RoaldVG/transistor-clock/modules/jkflipflop/production/bom.csv

Designator | Footprint | Quantity | Value | LCSC Part #
C1, C2, C3, C4, C5, C6, C7, C8 | 0603 | 8 | 100n | C14663
Q1, Q101, Q102, Q103, Q104, Q110, Q111, Q112, Q113, Q116, Q117, Q120, Q121, Q124, Q125, Q128, Q129, Q13, Q132, Q133, Q136, Q137, Q14, Q140, Q141, Q144, Q145, Q148, Q149, Q15, Q152, Q153, Q156, Q157, Q160, Q161, Q164, Q165, Q168, Q19, Q20, Q21, Q23, Q27, Q28, Q29, Q3, Q33, Q34, Q35, Q39, Q40, Q41, Q45, Q46, Q47, Q51, Q52, Q53, Q56, Q57, Q59, Q63, Q64, Q65, Q69, Q7, Q70, Q71, Q75, Q76, Q77, Q79, Q8, Q83, Q84, Q85, Q89, Q9, Q90, Q91, Q95, Q96, Q97 | SOT-23 | 84 | AO3401A | C15127
Q10, Q100, Q105, Q106, Q107, Q108, Q109, Q11, Q114, Q115, Q118, Q119, Q12, Q122, Q123, Q126, Q127, Q130, Q131, Q134, Q135, Q138, Q139, Q142, Q143, Q146, Q147, Q150, Q151, Q154, Q155, Q158, Q159, Q16, Q162, Q163, Q166, Q167, Q17, Q18, Q2, Q22, Q24, Q25, Q26, Q30, Q31, Q32, Q36, Q37, Q38, Q4, Q42, Q43, Q44, Q48, Q49, Q5, Q50, Q54, Q55, Q58, Q6, Q60, Q61, Q62, Q66, Q67, Q68, Q72, Q73, Q74, Q78, Q80, Q81, Q82, Q86, Q87, Q88, Q92, Q93, Q94, Q98, Q99 | SOT-23 | 84 | 2N7002 | C8545
