RoaldVG/transistor-clock/modules/bin-to-dec/production/bom.csv

Designator | Footprint | Quantity | Value | LCSC Part #
C1, C2, C3 | 0603 | 3 | 100n | C14663
Q1, Q10, Q11, Q14, Q16, Q18, Q19, Q20, Q21, Q25, Q28, Q29, Q30, Q31, Q32, Q38, Q39, Q4, Q40, Q42, Q43, Q45, Q46, Q48, Q49, Q51, Q57, Q58, Q6, Q60, Q63, Q68, Q69, Q7, Q71, Q73, Q9 | SOT-23 | 37 | 2N7002 | C8545
Q12, Q13, Q15, Q17, Q2, Q22, Q23, Q24, Q26, Q27, Q3, Q33, Q34, Q35, Q36, Q37, Q41, Q44, Q47, Q5, Q50, Q52, Q53, Q54, Q55, Q56, Q59, Q61, Q62, Q64, Q65, Q66, Q67, Q70, Q72, Q74, Q8 | SOT-23 | 37 | AO3401A | C15127
