RoaldVG/transistor-clock/sims/astable-multivibrator-sqr-12v.asc

C1: Cap; 10n
C2: Cap; 10n
C3: cap; 10n
L1: ind; 750µ; Rser=1m
L2: ind; 3.6nH; Rser=1m
M1: nmos; 2N7002
M2: pmos; DMP3099L
Q1: npn; 2N2222
Q2: npn; 2N2222
R1: Res; 15k
R2: Res; 130k
R3: Res; 130k
R4: Res; 15k
R5: res; 1k
R6: res; 1k
R7: res; 10
V1: Voltage; 12
V2: voltage; -12
Named nets: 0, V-out-2, V-out-1, out
.tran 10ms uic
*---------- DMP3099L Spice Model ----------
.SUBCKT DMP3099L 10 20 30
* TERMINALS : D G S
* MODEL FORMAT : SPICE3
* Editor : J
M1 1 2 3 3 PMOS L = 1E-006 W = 1E-006
RD 10 1 0.034
RS 30 3 0.001
RG 20 2 10.27
CGS 2 3 5.402E-010
EGD 12 30 2 1 1
VFB 14 30 0
FFB 2 1 VFB 1
CGD 13 14 4.4E-010
R1 13 30 1
D1 13 12 DLIM
DDG 14 15 DCGD
R2 12 15 1
D2 30 15 DLIM
DSD 10 3 DSUB
.MODEL PMOS PMOS LEVEL = 3 U0 = 400 VMAX = 1E+005 ETA = 0 IS = 0
+ TOX = 1E-007 NSUB = 1E+015 KP = 11.4 KAPPA = 0.2 VTO = -1.951
.MODEL DCGD D CJO = 2.23E-010 VJ = 0.5007 M = 0.4371
.MODEL DSUB D IS = 2.1E-009 N = 1.535 RS = 0.01225 BV = 33
+ CJO = 5.41E-011 VJ = 0.6 M = 0.5308 XTI=0
.MODEL DLIM D IS = 0.0001
.ENDS
K1 L1 L2 1
