RoaldVG/transistor-clock/modules/PSU/PSU.kicad_pcb

## KiCad design modules/PSU/PSU.kicad_pcb (2026-04-15)

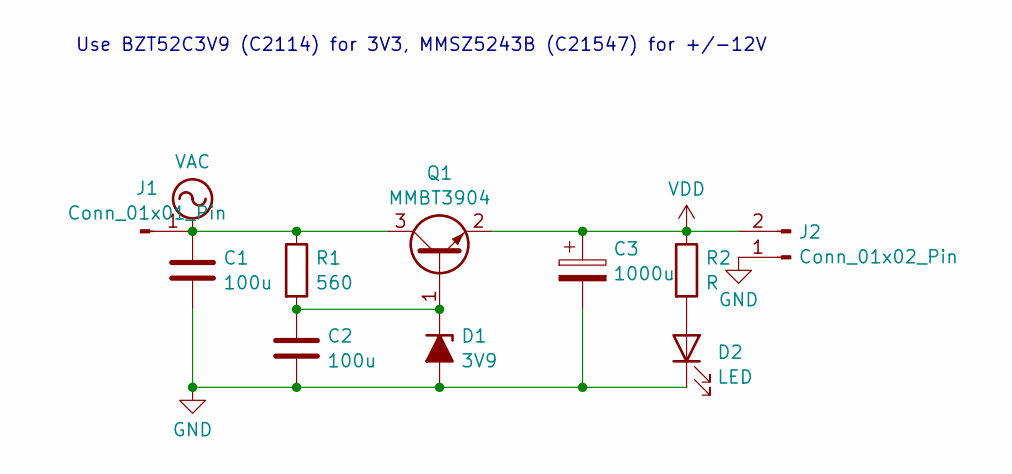
[picture p1: schematic PSU.kicad_sch]

Parts:
C1, C2: 100u; CP_EIA-3528-12_Kemet-T; LCSC Part # C16133
C3: 1000u; CP_Elec_10x10.5; LCSC Part # C3359
D1: 3V9; D_SOD-123; LCSC Part # C2114
D2: LED; LED_0603_1608Metric
J1: Conn_01x01_Pin; PinHeader_1x01_P2.54mm_Vertical
J2: Conn_01x02_Pin; PinHeader_1x02_P2.54mm_Vertical
Q1: MMBT3904; SOT-23; LCSC Part # C20526v
R1: 560; R_0603_1608Metric; LCSC Part # C23204
R2: R; R_0603_1608Metric

Connections:
GND: C1.2, C2.1, C3.2, D1.2 (A), D2.1 (K), J2.1
unnamed: C2.2, D1.1 (K), Q1.1 (B), R1.2
unnamed: D2.2 (A), R2.2
VAC: C1.1, J1.1, Q1.3 (C), R1.1
VDD: C3.1, J2.2, Q1.2 (E), R2.1

Notes on the sheet:
Use BZT52C3V9 (C2114) for 3V3, MMSZ5243B (C21547) for +/-12V

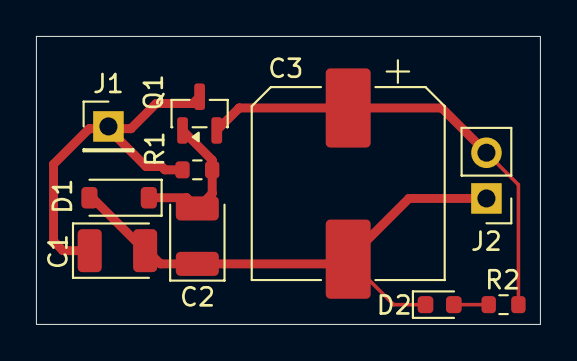
[picture p2: board PSU.kicad_pcb from above]

Board: 2 copper layers, 28.0 x 16.0 mm, 10 parts (0 on the bottom side), 5 nets.
