RoaldVG/transistor-clock/transistor-clock.kicad_pcb

## KiCad design transistor-clock.kicad_pcb (2026-04-15)

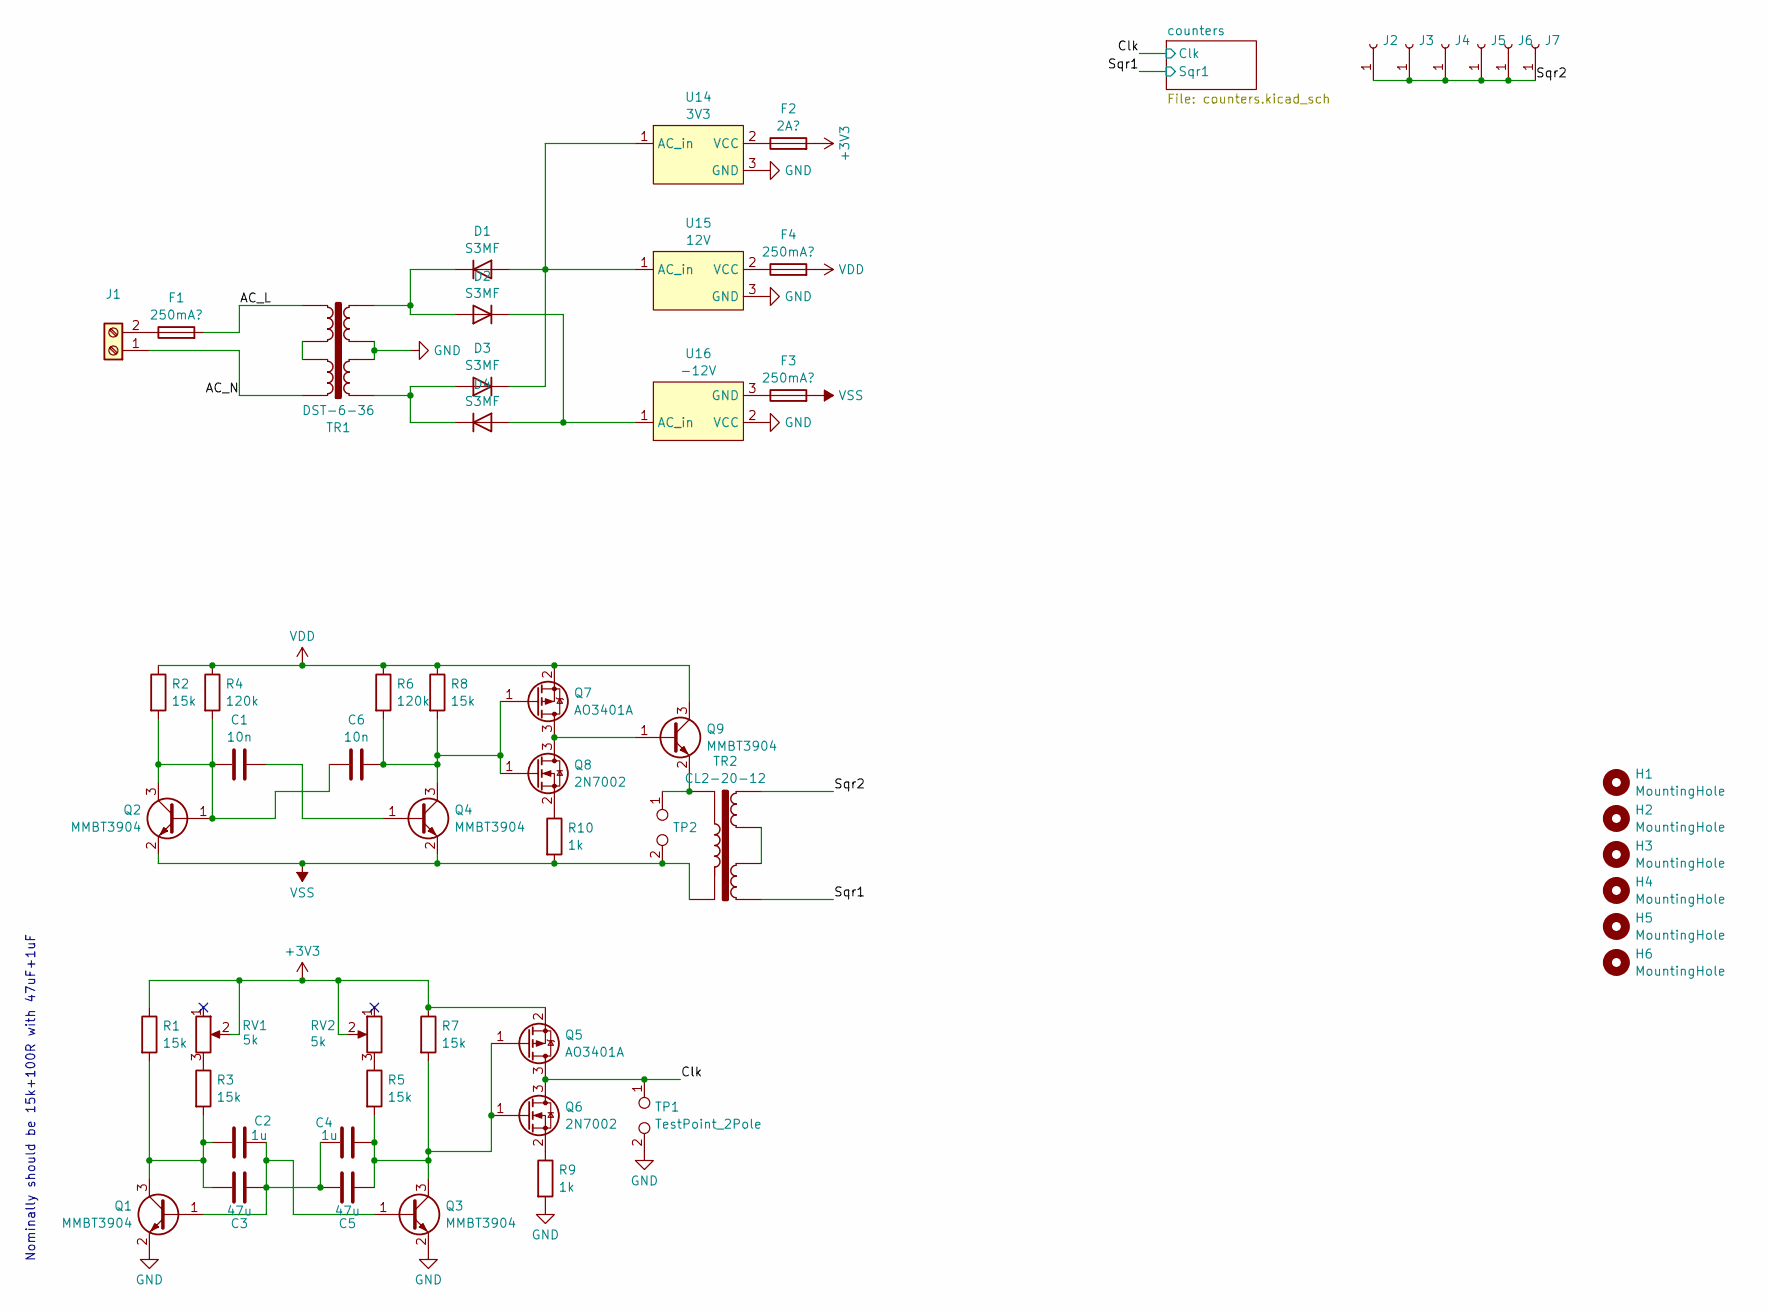
[picture p3: schematic transistor-clock.kicad_sch]

Parts:
C1, C6: 10n; C_0603_1608Metric; LCSC Part # C57112
C2, C4: 1u; C_0603_1608Metric; LCSC Part # C15849
C3, C5: 47u; C_0805_2012Metric; LCSC Part # C16780
D1, D2, D3, D4: S3MF; D_SMA; LCSC Part # C64874
F1, F3, F4: 250mA?; Fuse_Littelfuse-NANO2-885; LCSC Part # C41371860
F2: 2A?; Fuse_Littelfuse-NANO2-885; LCSC Part # C41371860
H1, H2, H3, H4, H5, H6: MountingHole; MountingHole_4.3mm_M4_DIN965
J1: Screw_Terminal_01x02; TerminalBlock_MaiXu_MX126-5.0-02P_1x02_P5.00mm
J2, J3, J4, J5, J6, J7: Conn_01x01_Socket; PinHeader_1x01_P2.54mm_Vertical
Q1, Q2, Q3, Q4, Q9: MMBT3904; SOT-23; LCSC Part # C20526v
Q5, Q7: AO3401A; SOT-23; LCSC Part # C15127
Q6, Q8: 2N7002; SOT-23; LCSC Part # C8545
R1, R2, R3, R5, R7, R8: 15k; R_0603_1608Metric; LCSC Part # C22809
R4, R6: 120k; R_0603_1608Metric; LCSC Part # C25808
R9, R10: 1k; R_0603_1608Metric; LCSC Part # C21190
RV1, RV2: 5k; Potentiometer_Bourns_3214J_Horizontal; LCSC Part # C58391
TP1, TP2: TestPoint_2Pole; PinHeader_1x02_P2.54mm_Vertical
TR1: DST-6-36
TR2: CL2-20-12
U14: 3V3; module_PSU
U15: 12V; module_PSU
U16: -12V; module_PSU

Connections:
+3V3: F2.2, Q5.2 (S), R1.1, R7.1, RV1.2, RV2.2; also elsewhere on the board
/AC_L: F1.2, TR1.4
/AC_N: J1.1, TR1.1
/Clk: Q5.3 (D), Q6.3 (D), TP1.1; also elsewhere on the board
/Sqr1: TR2.1; also elsewhere on the board
/Sqr2: J2.1, J3.1, J4.1, J5.1, J6.1, J7.1, TR2.6
GND: Q1.2 (E), Q3.2 (E), R9.2, TP1.2, TR1.6, TR1.7, U14.3 (GND), U15.3 (GND), U16.2 (VCC); also elsewhere on the board
unnamed: D1.2 (A), D3.1 (K), U14.1 (AC_in), U15.1 (AC_in)
unnamed: D1.1 (K), D2.2 (A), TR1.5
unnamed: D2.1 (K), D4.2 (A), U16.1 (AC_in)
unnamed: D3.2 (A), D4.1 (K), TR1.8
unnamed: F1.1, J1.2
unnamed: C2.2, C3.2, C4.1, C5.1, Q1.1 (B), Q3.1 (B)
unnamed: C2.1, C3.1, Q1.3 (C), R1.2, R3.2
unnamed: C1.1, C6.1, Q2.1 (B), Q2.3 (C), R2.2, R4.2
unnamed: C4.2, C5.2, Q3.3 (C), Q5.1 (G), Q6.1 (G), R5.2, R7.2
unnamed: C1.2, Q4.1 (B)
unnamed: C6.2, Q4.3 (C), Q7.1 (G), Q8.1 (G), R6.2, R8.2
unnamed: Q6.2 (S), R9.1
unnamed: Q7.3 (D), Q8.3 (D), Q9.1 (B)
unnamed: Q8.2 (S), R10.1
unnamed: Q9.2 (E), TP2.1, TR2.12
unnamed: R3.1, RV1.3
unnamed: R5.1, RV2.3
unnamed: TR1.2, TR1.3
unnamed: TR2.3, TR2.4
unnamed: F2.1, U14.2 (VCC)
unnamed: F4.1, U15.2 (VCC)
unnamed: F3.1, U16.3 (GND)
VDD: F4.2, Q7.2 (S), Q9.3 (C), R2.1, R4.1, R6.1, R8.1
VSS: F3.2, Q2.2 (E), Q4.2 (E), R10.2, TP2.2, TR2.7

Notes on the sheet:
Nominally should be 15k+100R with 47uF+1uF

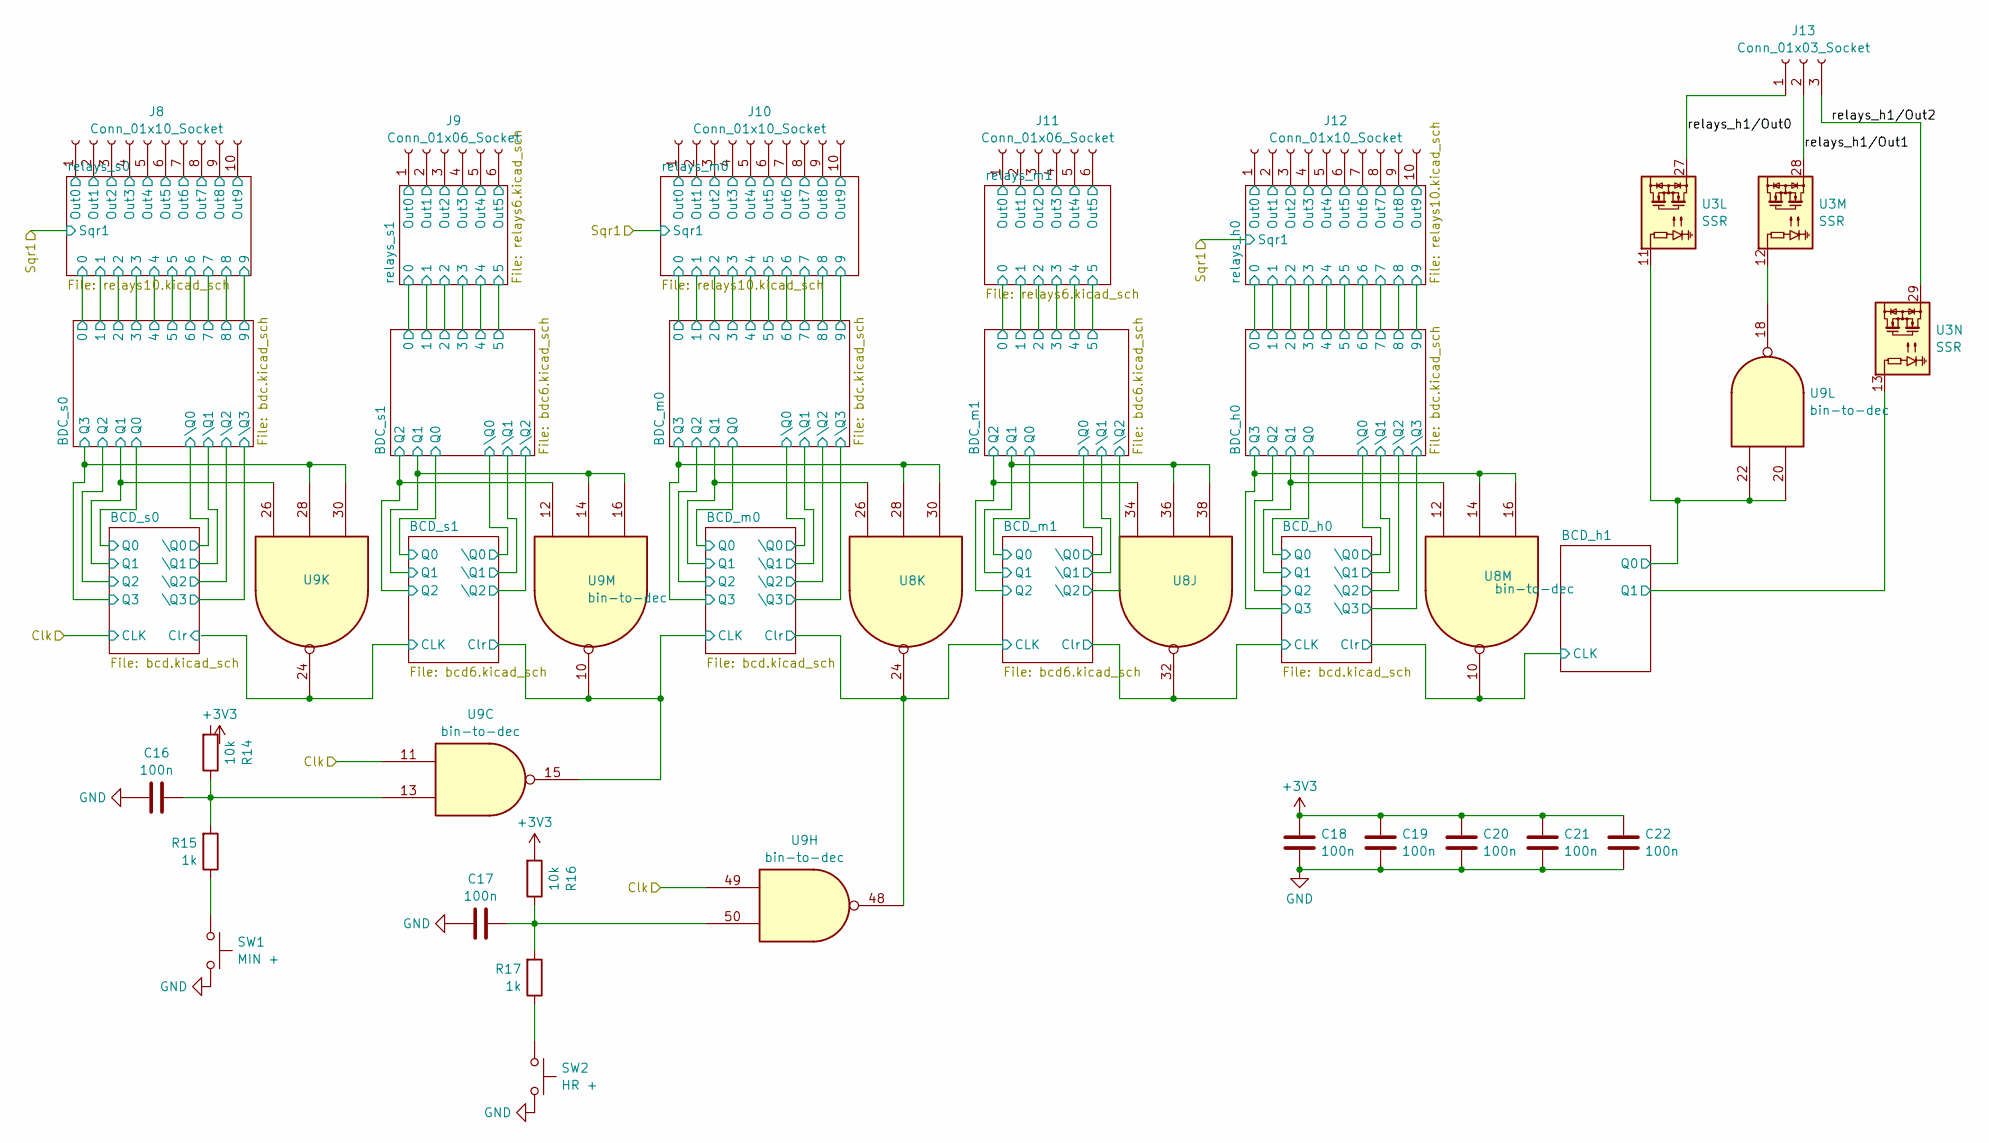
[picture p4: schematic counters.kicad_sch]

Parts:
C16, C17, C18, C19, C20, C21, C22: 100n; C_0603_1608Metric; LCSC Part # C14663
J8, J10, J12: Conn_01x10_Socket; PinHeader_1x10_P2.54mm_Vertical
J9, J11: Conn_01x06_Socket; PinHeader_1x06_P2.54mm_Vertical
J13: Conn_01x03_Socket; PinHeader_1x03_P2.54mm_Vertical
R14, R16: 10k; R_0603_1608Metric; LCSC Part # C25804
R15, R17: 1k; R_0603_1608Metric; LCSC Part # C21190
SW1: MIN +; SW_SPST_EVQPE1; LCSC Part # C720477
SW2: HR +; SW_SPST_EVQPE1; LCSC Part # C720477
U3: SSR; module_ssr
U8, U9: bin-to-dec; module_bdc_mpcie; LCSC Part # C185937

Connections:
+3V3: C18.1, C19.1, C20.1, C21.1, C22.1, R16.2, U8.24, U8.32, U9.10, U9.15, U9.24, U9.48; also elsewhere on the board
/Clk: U9.11, U9.49; also elsewhere on the board
/counters/BCD_h0/Clr: U8.10; also elsewhere on the board
/counters/BCD_h0/Q1: U8.12; also elsewhere on the board
/counters/BCD_h0/Q3: U8.14, U8.16; also elsewhere on the board
/counters/BCD_h1/Clr: U3.13; also elsewhere on the board
/counters/BCD_h1/Q0: U3.11, U9.20, U9.22; also elsewhere on the board
/counters/BCD_m0/Q1: U8.26; also elsewhere on the board
/counters/BCD_m0/Q3: U8.28, U8.30; also elsewhere on the board
/counters/BCD_m1/Q1: U8.36, U8.38; also elsewhere on the board
/counters/BCD_m1/Q2: U8.34; also elsewhere on the board
/counters/BCD_s0/Q1: U9.26; also elsewhere on the board
/counters/BCD_s0/Q3: U9.28, U9.30; also elsewhere on the board
/counters/BCD_s1/Q1: U9.14, U9.16; also elsewhere on the board
/counters/BCD_s1/Q2: U9.12; also elsewhere on the board
/counters/relays_h0/Out0: J12.1; also elsewhere on the board
/counters/relays_h0/Out1: J12.2; also elsewhere on the board
/counters/relays_h0/Out2: J12.3; also elsewhere on the board
/counters/relays_h0/Out3: J12.4; also elsewhere on the board
/counters/relays_h0/Out4: J12.5; also elsewhere on the board
/counters/relays_h0/Out5: J12.6; also elsewhere on the board
/counters/relays_h0/Out6: J12.7; also elsewhere on the board
/counters/relays_h0/Out7: J12.8; also elsewhere on the board
/counters/relays_h0/Out8: J12.9; also elsewhere on the board
/counters/relays_h0/Out9: J12.10; also elsewhere on the board
/counters/relays_h1/Out0: J13.1, U3.27
/counters/relays_h1/Out1: J13.2, U3.28
/counters/relays_h1/Out2: J13.3, U3.29
/counters/relays_m0/Out0: J10.1; also elsewhere on the board
/counters/relays_m0/Out1: J10.2; also elsewhere on the board
/counters/relays_m0/Out2: J10.3; also elsewhere on the board
/counters/relays_m0/Out3: J10.4; also elsewhere on the board
/counters/relays_m0/Out4: J10.5; also elsewhere on the board
/counters/relays_m0/Out5: J10.6; also elsewhere on the board
/counters/relays_m0/Out6: J10.7; also elsewhere on the board
/counters/relays_m0/Out7: J10.8; also elsewhere on the board
/counters/relays_m0/Out8: J10.9; also elsewhere on the board
/counters/relays_m0/Out9: J10.10; also elsewhere on the board
/counters/relays_m1/Out0: J11.1; also elsewhere on the board
/counters/relays_m1/Out1: J11.2; also elsewhere on the board
/counters/relays_m1/Out2: J11.3; also elsewhere on the board
/counters/relays_m1/Out3: J11.4; also elsewhere on the board
/counters/relays_m1/Out4: J11.5; also elsewhere on the board
/counters/relays_m1/Out5: J11.6; also elsewhere on the board
/counters/relays_s0/Out0: J8.1; also elsewhere on the board
/counters/relays_s0/Out1: J8.2; also elsewhere on the board
/counters/relays_s0/Out2: J8.3; also elsewhere on the board
/counters/relays_s0/Out3: J8.4; also elsewhere on the board
/counters/relays_s0/Out4: J8.5; also elsewhere on the board
/counters/relays_s0/Out5: J8.6; also elsewhere on the board
/counters/relays_s0/Out6: J8.7; also elsewhere on the board
/counters/relays_s0/Out7: J8.8; also elsewhere on the board
/counters/relays_s0/Out8: J8.9; also elsewhere on the board
/counters/relays_s0/Out9: J8.10; also elsewhere on the board
/counters/relays_s1/Out0: J9.1; also elsewhere on the board
/counters/relays_s1/Out1: J9.2; also elsewhere on the board
/counters/relays_s1/Out2: J9.3; also elsewhere on the board
/counters/relays_s1/Out3: J9.4; also elsewhere on the board
/counters/relays_s1/Out4: J9.5; also elsewhere on the board
/counters/relays_s1/Out5: J9.6; also elsewhere on the board
GND: C16.2, C17.2, C18.2, C19.2, C20.2, C21.2, C22.2, SW1.1, SW2.1; also elsewhere on the board
unnamed: C16.1, R14.1, R15.2, U9.13
unnamed: C17.1, R16.1, R17.2, U9.50
unnamed: R15.1, SW1.2
unnamed: R17.1, SW2.2
unnamed: U3.12, U9.18

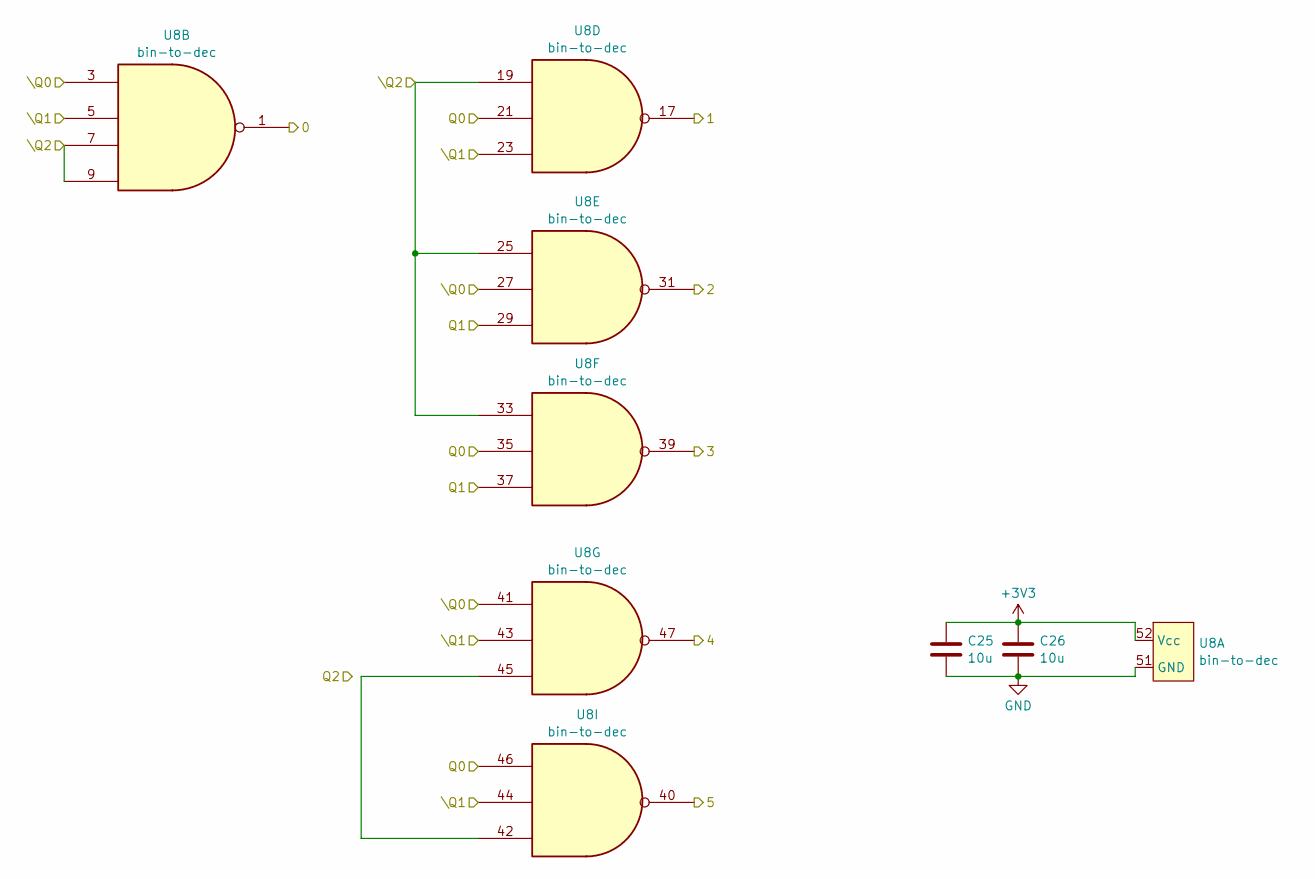
[picture p5: schematic bdc6.kicad_sch]

Parts:
C25, C26: 10u; C_0603_1608Metric; LCSC Part # C19702
U8: bin-to-dec; module_bdc_mpcie; LCSC Part # C185937

Connections:
+3V3: C25.1, C26.1, U8.52 (Vcc); also elsewhere on the board
/counters/BCD_m1/Q0: U8.21, U8.35, U8.46; also elsewhere on the board
/counters/BCD_m1/Q1: U8.29, U8.37; also elsewhere on the board
/counters/BCD_m1/\Q0: U8.3, U8.27, U8.41; also elsewhere on the board
/counters/BCD_m1/\Q1: U8.5, U8.23, U8.43, U8.44; also elsewhere on the board
/counters/BCD_m1/\Q2: U8.7, U8.9, U8.19, U8.25, U8.33; also elsewhere on the board
/counters/BDC_m1/0: U8.1; also elsewhere on the board
/counters/BDC_m1/1: U8.17; also elsewhere on the board
/counters/BDC_m1/2: U8.31; also elsewhere on the board
/counters/BDC_m1/3: U8.39; also elsewhere on the board
/counters/BDC_m1/4: U8.47; also elsewhere on the board
/counters/BDC_m1/5: U8.40; also elsewhere on the board
GND: C25.2, C26.2, U8.51 (GND); also elsewhere on the board
unnamed: U8.42, U8.45

Parts of its further copies:
C31, C32: 10u; C_0603_1608Metric; LCSC Part # C19702

Connections of its further copies:
+3V3: C31.1, C32.1; also elsewhere on the board
GND: C31.2, C32.2; also elsewhere on the board

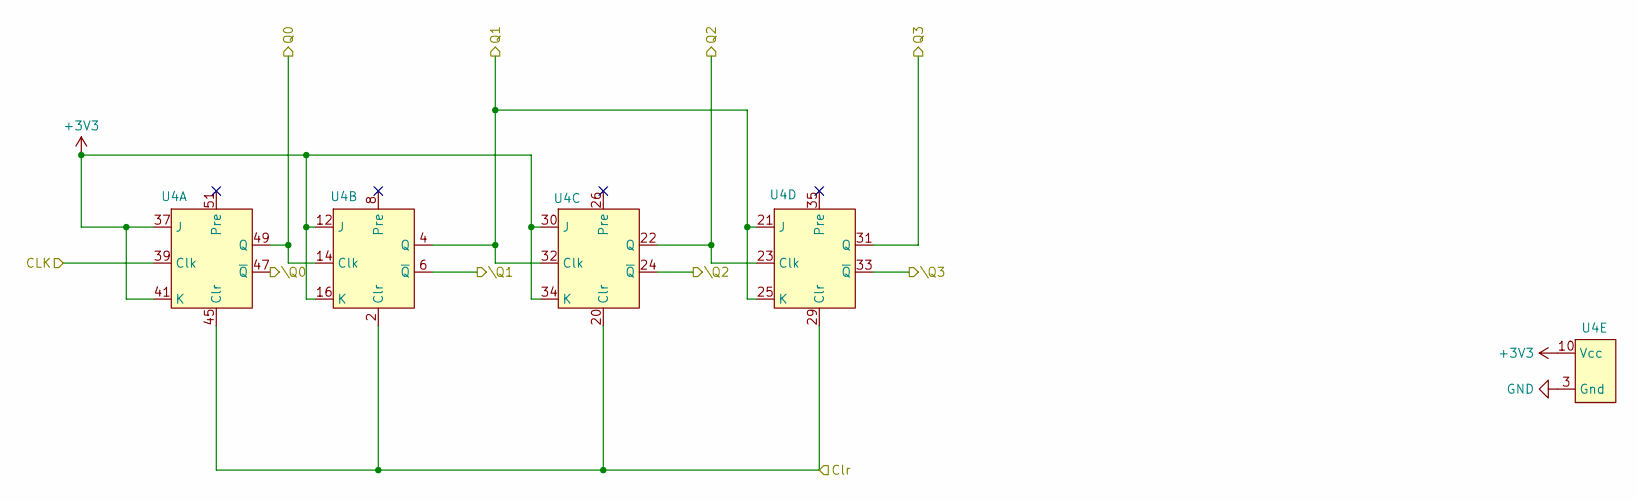
[picture p6: schematic bcd.kicad_sch]

Parts:
U4: flipflop; module_flipflop_mpcie; LCSC Part # C185937

Connections:
+3V3: U4.10 (Vcc), U4.12 (J), U4.16 (K), U4.18 (Vcc), U4.28 (Vcc), U4.30 (J), U4.34 (K), U4.36 (Vcc), U4.37 (J), U4.39 (Clk), U4.41 (K), U4.46 (Vcc); also elsewhere on the board
/counters/BCD_h0/Clr: U4.2 (Clr), U4.20 (Clr), U4.29 (Clr), U4.45 (Clr); also elsewhere on the board
/counters/BCD_h0/Q0: U4.14 (Clk), U4.49 (Q); also elsewhere on the board
/counters/BCD_h0/Q1: U4.4 (Q), U4.21 (J), U4.25 (K), U4.32 (Clk); also elsewhere on the board
/counters/BCD_h0/Q2: U4.22 (Q), U4.23 (Clk); also elsewhere on the board
/counters/BCD_h0/Q3: U4.31 (Q); also elsewhere on the board
/counters/BCD_h0/\Q0: U4.47 (~Q); also elsewhere on the board
/counters/BCD_h0/\Q1: U4.6 (~Q); also elsewhere on the board
/counters/BCD_h0/\Q2: U4.24 (~Q); also elsewhere on the board
/counters/BCD_h0/\Q3: U4.33 (~Q); also elsewhere on the board
GND: U4.3 (Gnd), U4.9 (Gnd), U4.19 (Gnd), U4.27 (Gnd), U4.43 (Gnd); also elsewhere on the board

Parts of its further copies:
U7, U10: flipflop; module_flipflop_mpcie; LCSC Part # C185937

Connections of its further copies:
+3V3: U7.10 (Vcc), U7.12 (J), U7.16 (K), U7.18 (Vcc), U7.28 (Vcc), U7.30 (J), U7.34 (K), U7.36 (Vcc), U7.37 (J), U7.41 (K), U7.46 (Vcc), U10.2 (Clr), U10.10 (Vcc), U10.12 (J), U10.16 (K), U10.18 (Vcc), U10.20 (Clr), U10.28 (Vcc), U10.29 (Clr), U10.30 (J), U10.34 (K), U10.36 (Vcc), U10.37 (J), U10.39 (Clk), U10.41 (K), U10.45 (Clr), U10.46 (Vcc); also elsewhere on the board
/Clk: U7.39 (Clk); also elsewhere on the board
/counters/BCD_m0/Q0: U10.14 (Clk), U10.49 (Q); also elsewhere on the board
/counters/BCD_m0/Q1: U10.4 (Q), U10.21 (J), U10.25 (K), U10.32 (Clk); also elsewhere on the board
/counters/BCD_m0/Q2: U10.22 (Q), U10.23 (Clk); also elsewhere on the board
/counters/BCD_m0/Q3: U10.31 (Q); also elsewhere on the board
/counters/BCD_m0/\Q0: U10.47 (~Q); also elsewhere on the board
/counters/BCD_m0/\Q1: U10.6 (~Q); also elsewhere on the board
/counters/BCD_m0/\Q2: U10.24 (~Q); also elsewhere on the board
/counters/BCD_m0/\Q3: U10.33 (~Q); also elsewhere on the board
/counters/BCD_s0/Clr: U7.2 (Clr), U7.20 (Clr), U7.29 (Clr), U7.45 (Clr)
/counters/BCD_s0/Q0: U7.14 (Clk), U7.49 (Q); also elsewhere on the board
/counters/BCD_s0/Q1: U7.4 (Q), U7.21 (J), U7.25 (K), U7.32 (Clk); also elsewhere on the board
/counters/BCD_s0/Q2: U7.22 (Q), U7.23 (Clk); also elsewhere on the board
/counters/BCD_s0/Q3: U7.31 (Q); also elsewhere on the board
/counters/BCD_s0/\Q0: U7.47 (~Q); also elsewhere on the board
/counters/BCD_s0/\Q1: U7.6 (~Q); also elsewhere on the board
/counters/BCD_s0/\Q2: U7.24 (~Q); also elsewhere on the board
/counters/BCD_s0/\Q3: U7.33 (~Q); also elsewhere on the board
GND: U7.3 (Gnd), U7.9 (Gnd), U7.19 (Gnd), U7.27 (Gnd), U7.43 (Gnd), U10.3 (Gnd), U10.9 (Gnd), U10.19 (Gnd), U10.27 (Gnd), U10.43 (Gnd); also elsewhere on the board

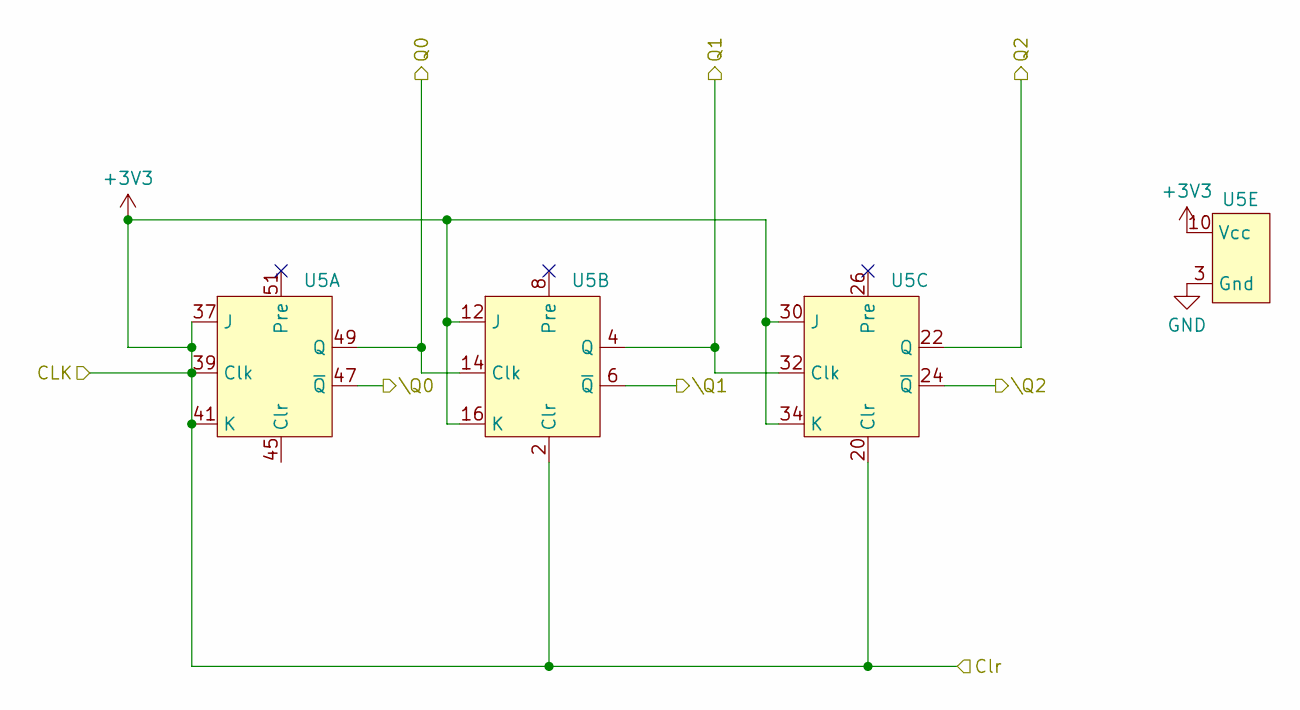
[picture p7: schematic bcd6.kicad_sch]

Parts:
U5: flipflop; module_flipflop_mpcie; LCSC Part # C185937

Connections:
+3V3: U5.2 (Clr), U5.10 (Vcc), U5.12 (J), U5.16 (K), U5.18 (Vcc), U5.20 (Clr), U5.28 (Vcc), U5.30 (J), U5.34 (K), U5.36 (Vcc), U5.37 (J), U5.39 (Clk), U5.41 (K), U5.46 (Vcc); also elsewhere on the board
/counters/BCD_s1/Q0: U5.14 (Clk), U5.49 (Q); also elsewhere on the board
/counters/BCD_s1/Q1: U5.4 (Q), U5.32 (Clk); also elsewhere on the board
/counters/BCD_s1/Q2: U5.22 (Q); also elsewhere on the board
/counters/BCD_s1/\Q0: U5.47 (~Q); also elsewhere on the board
/counters/BCD_s1/\Q1: U5.6 (~Q); also elsewhere on the board
/counters/BCD_s1/\Q2: U5.24 (~Q); also elsewhere on the board
GND: U5.3 (Gnd), U5.9 (Gnd), U5.19 (Gnd), U5.27 (Gnd), U5.43 (Gnd); also elsewhere on the board

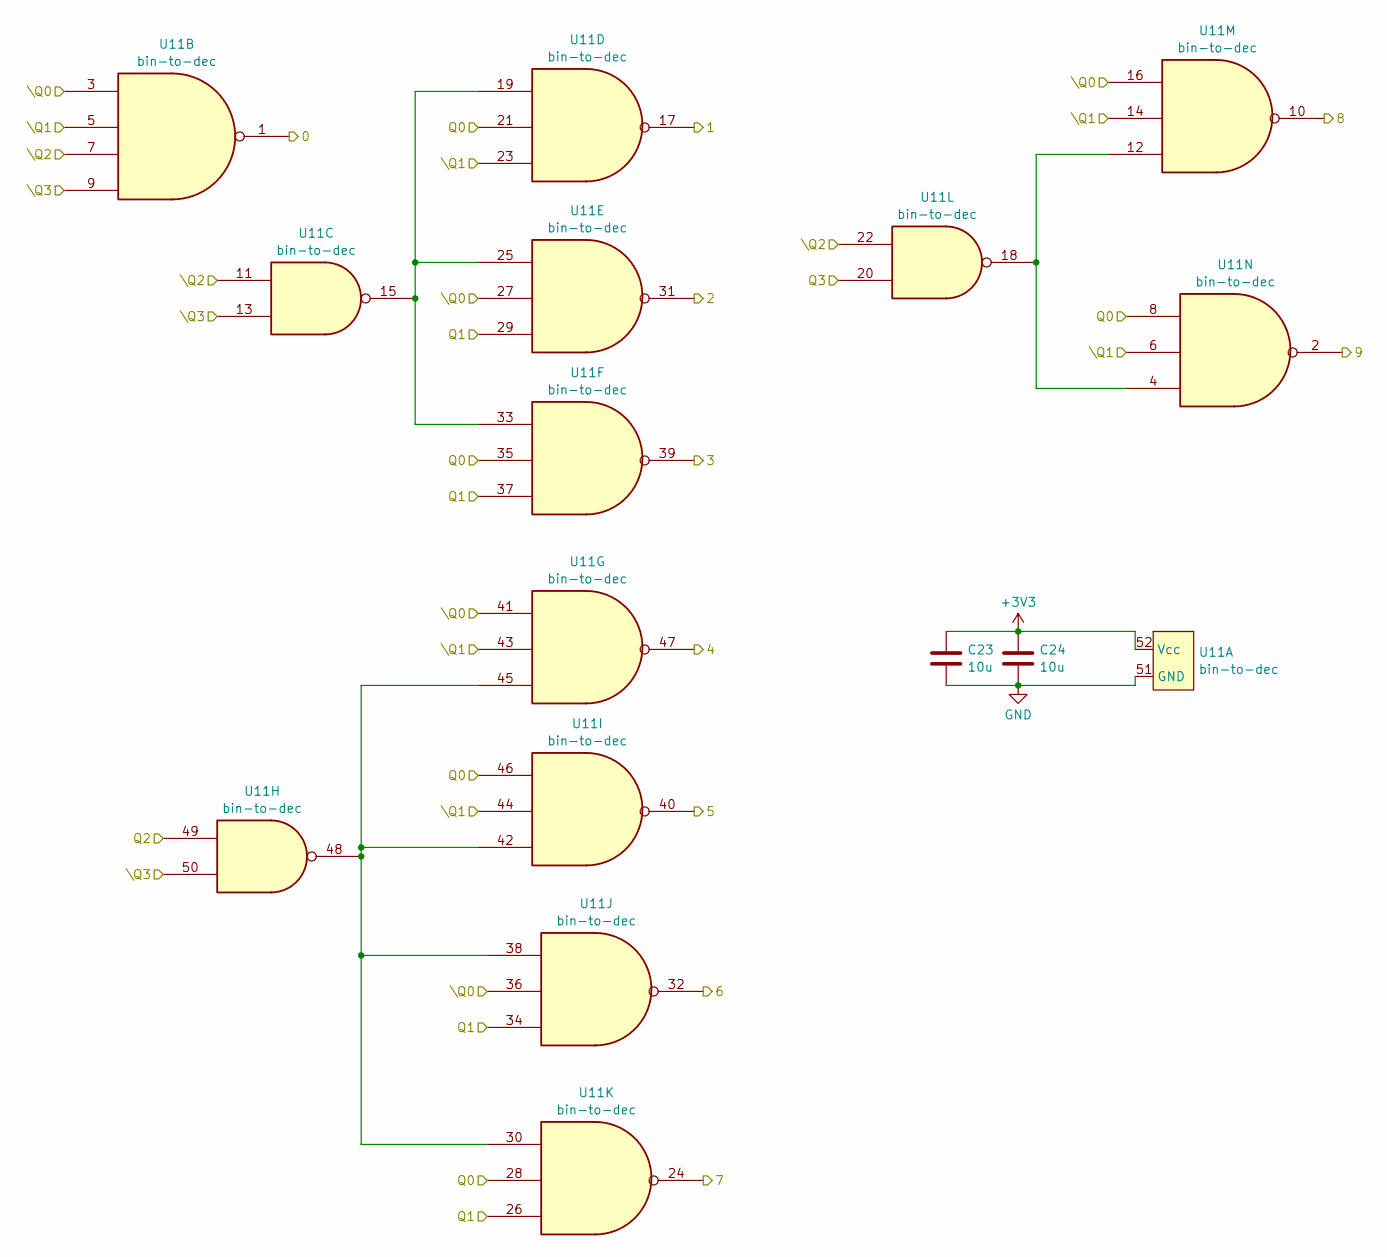
[picture p8: schematic bdc.kicad_sch]

Parts:
C23, C24: 10u; C_0603_1608Metric; LCSC Part # C19702
U11: bin-to-dec; module_bdc_mpcie; LCSC Part # C185937

Connections:
+3V3: C23.1, C24.1, U11.52 (Vcc); also elsewhere on the board
/counters/BCD_m0/Q0: U11.8, U11.21, U11.28, U11.35, U11.46; also elsewhere on the board
/counters/BCD_m0/Q1: U11.26, U11.29, U11.34, U11.37; also elsewhere on the board
/counters/BCD_m0/Q2: U11.49; also elsewhere on the board
/counters/BCD_m0/Q3: U11.20; also elsewhere on the board
/counters/BCD_m0/\Q0: U11.3, U11.16, U11.27, U11.36, U11.41; also elsewhere on the board
/counters/BCD_m0/\Q1: U11.5, U11.6, U11.14, U11.23, U11.43, U11.44; also elsewhere on the board
/counters/BCD_m0/\Q2: U11.7, U11.11, U11.22; also elsewhere on the board
/counters/BCD_m0/\Q3: U11.9, U11.13, U11.50; also elsewhere on the board
/counters/BDC_m0/0: U11.1; also elsewhere on the board
/counters/BDC_m0/1: U11.17; also elsewhere on the board
/counters/BDC_m0/2: U11.31; also elsewhere on the board
/counters/BDC_m0/3: U11.39; also elsewhere on the board
/counters/BDC_m0/4: U11.47; also elsewhere on the board
/counters/BDC_m0/5: U11.40; also elsewhere on the board
/counters/BDC_m0/6: U11.32; also elsewhere on the board
/counters/BDC_m0/7: U11.24; also elsewhere on the board
/counters/BDC_m0/8: U11.10; also elsewhere on the board
/counters/BDC_m0/9: U11.2; also elsewhere on the board
GND: C23.2, C24.2, U11.51 (GND); also elsewhere on the board
unnamed: U11.4, U11.12, U11.18
unnamed: U11.15, U11.19, U11.25, U11.33
unnamed: U11.30, U11.38, U11.42, U11.45, U11.48

Parts of its further copies:
C27, C28, C29, C30: 10u; C_0603_1608Metric; LCSC Part # C19702
U12, U13: bin-to-dec; module_bdc_mpcie; LCSC Part # C185937

Connections of its further copies:
+3V3: C27.1, C28.1, C29.1, C30.1, U12.52 (Vcc), U13.52 (Vcc); also elsewhere on the board
/counters/BCD_h0/Q0: U12.8, U12.21, U12.28, U12.35, U12.46; also elsewhere on the board
/counters/BCD_h0/Q1: U12.26, U12.29, U12.34, U12.37; also elsewhere on the board
/counters/BCD_h0/Q2: U12.49; also elsewhere on the board
/counters/BCD_h0/Q3: U12.20; also elsewhere on the board
/counters/BCD_h0/\Q0: U12.3, U12.16, U12.27, U12.36, U12.41; also elsewhere on the board
/counters/BCD_h0/\Q1: U12.5, U12.6, U12.14, U12.23, U12.43, U12.44; also elsewhere on the board
/counters/BCD_h0/\Q2: U12.7, U12.11, U12.22; also elsewhere on the board
/counters/BCD_h0/\Q3: U12.9, U12.13, U12.50; also elsewhere on the board
/counters/BCD_s0/Q0: U13.8, U13.21, U13.28, U13.35, U13.46; also elsewhere on the board
/counters/BCD_s0/Q1: U13.26, U13.29, U13.34, U13.37; also elsewhere on the board
/counters/BCD_s0/Q2: U13.49; also elsewhere on the board
/counters/BCD_s0/Q3: U13.20; also elsewhere on the board
/counters/BCD_s0/\Q0: U13.3, U13.16, U13.27, U13.36, U13.41; also elsewhere on the board
/counters/BCD_s0/\Q1: U13.5, U13.6, U13.14, U13.23, U13.43, U13.44; also elsewhere on the board
/counters/BCD_s0/\Q2: U13.7, U13.11, U13.22; also elsewhere on the board
/counters/BCD_s0/\Q3: U13.9, U13.13, U13.50; also elsewhere on the board
/counters/BDC_h0/0: U12.1; also elsewhere on the board
/counters/BDC_h0/1: U12.17; also elsewhere on the board
/counters/BDC_h0/2: U12.31; also elsewhere on the board
/counters/BDC_h0/3: U12.39; also elsewhere on the board
/counters/BDC_h0/4: U12.47; also elsewhere on the board
/counters/BDC_h0/5: U12.40; also elsewhere on the board
/counters/BDC_h0/6: U12.32; also elsewhere on the board
/counters/BDC_h0/7: U12.24; also elsewhere on the board
/counters/BDC_h0/8: U12.10; also elsewhere on the board
/counters/BDC_h0/9: U12.2; also elsewhere on the board
/counters/BDC_s0/0: U13.1; also elsewhere on the board
/counters/BDC_s0/1: U13.17; also elsewhere on the board
/counters/BDC_s0/2: U13.31; also elsewhere on the board
/counters/BDC_s0/3: U13.39; also elsewhere on the board
/counters/BDC_s0/4: U13.47; also elsewhere on the board
/counters/BDC_s0/5: U13.40; also elsewhere on the board
/counters/BDC_s0/6: U13.32; also elsewhere on the board
/counters/BDC_s0/7: U13.24; also elsewhere on the board
/counters/BDC_s0/8: U13.10; also elsewhere on the board
/counters/BDC_s0/9: U13.2; also elsewhere on the board
GND: C27.2, C28.2, C29.2, C30.2, U12.51 (GND), U13.51 (GND); also elsewhere on the board
unnamed: U12.4, U12.12, U12.18
unnamed: U12.15, U12.19, U12.25, U12.33
unnamed: U12.30, U12.38, U12.42, U12.45, U12.48
unnamed: U13.4, U13.12, U13.18
unnamed: U13.15, U13.19, U13.25, U13.33
unnamed: U13.30, U13.38, U13.42, U13.45, U13.48

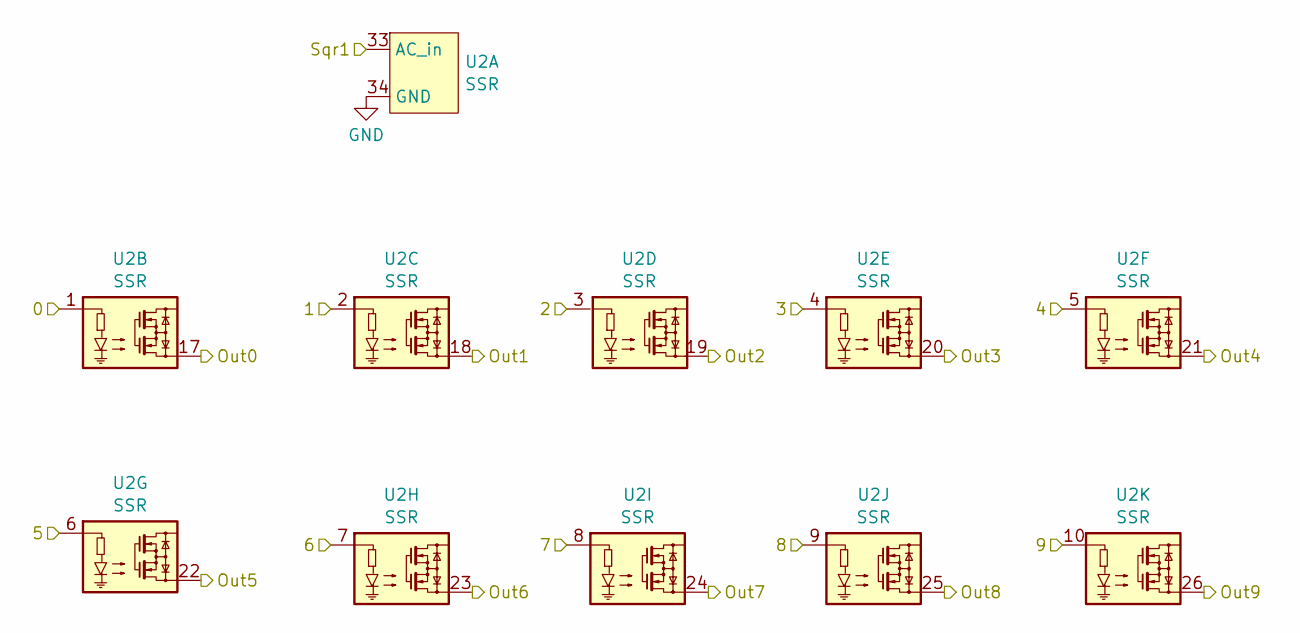
[picture p9: schematic relays10.kicad_sch]

Parts:
U2: SSR; module_ssr

Connections:
/Sqr1: U2.33 (AC_in); also elsewhere on the board
/counters/BDC_m0/0: U2.1; also elsewhere on the board
/counters/BDC_m0/1: U2.2; also elsewhere on the board
/counters/BDC_m0/2: U2.3; also elsewhere on the board
/counters/BDC_m0/3: U2.4; also elsewhere on the board
/counters/BDC_m0/4: U2.5; also elsewhere on the board
/counters/BDC_m0/5: U2.6; also elsewhere on the board
/counters/BDC_m0/6: U2.7; also elsewhere on the board
/counters/BDC_m0/7: U2.8; also elsewhere on the board
/counters/BDC_m0/8: U2.9; also elsewhere on the board
/counters/BDC_m0/9: U2.10; also elsewhere on the board
/counters/relays_m0/Out0: U2.17; also elsewhere on the board
/counters/relays_m0/Out1: U2.18; also elsewhere on the board
/counters/relays_m0/Out2: U2.19; also elsewhere on the board
/counters/relays_m0/Out3: U2.20; also elsewhere on the board
/counters/relays_m0/Out4: U2.21; also elsewhere on the board
/counters/relays_m0/Out5: U2.22; also elsewhere on the board
/counters/relays_m0/Out6: U2.23; also elsewhere on the board
/counters/relays_m0/Out7: U2.24; also elsewhere on the board
/counters/relays_m0/Out8: U2.25; also elsewhere on the board
/counters/relays_m0/Out9: U2.26; also elsewhere on the board
GND: U2.34 (GND); also elsewhere on the board

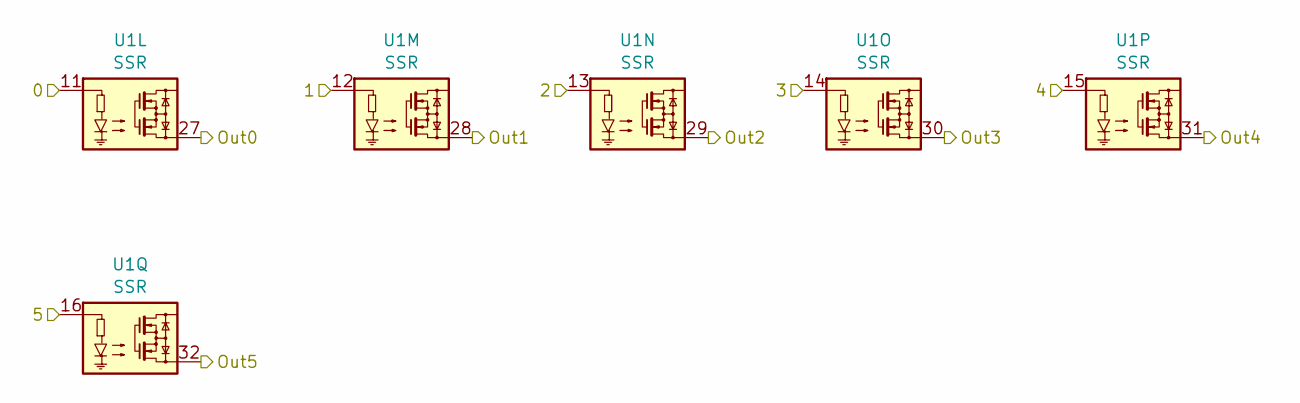
[picture p10: schematic relays6.kicad_sch]

Parts:
U1: SSR; module_ssr

Connections:
/counters/BDC_s1/0: U1.11; also elsewhere on the board
/counters/BDC_s1/1: U1.12; also elsewhere on the board
/counters/BDC_s1/2: U1.13; also elsewhere on the board
/counters/BDC_s1/3: U1.14; also elsewhere on the board
/counters/BDC_s1/4: U1.15; also elsewhere on the board
/counters/BDC_s1/5: U1.16; also elsewhere on the board
/counters/relays_s1/Out0: U1.27; also elsewhere on the board
/counters/relays_s1/Out1: U1.28; also elsewhere on the board
/counters/relays_s1/Out2: U1.29; also elsewhere on the board
/counters/relays_s1/Out3: U1.30; also elsewhere on the board
/counters/relays_s1/Out4: U1.31; also elsewhere on the board
/counters/relays_s1/Out5: U1.32; also elsewhere on the board
