RoaldVG/transistor-clock/transistor-clock.kicad_pcb

## KiCad design transistor-clock.kicad_pcb (continued)

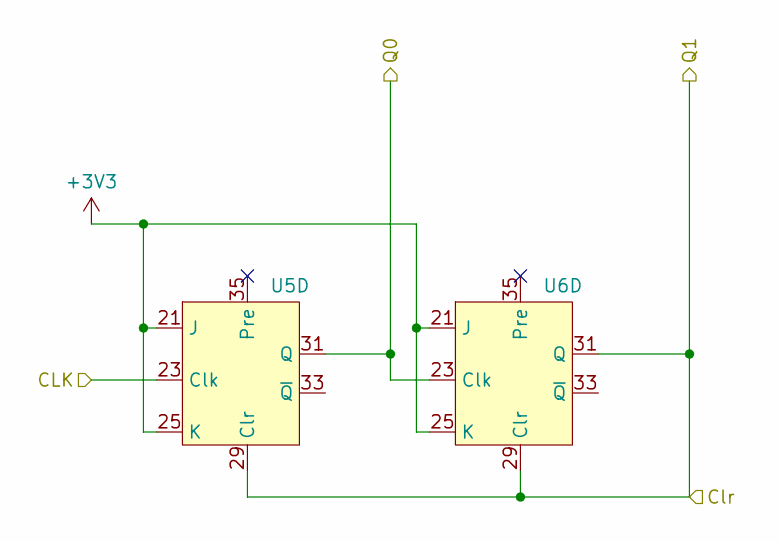
[picture p11: schematic bcd2.kicad_sch]

Parts:
U5, U6: flipflop; module_flipflop_mpcie; LCSC Part # C185937

Connections:
+3V3: U5.21 (J), U5.25 (K), U6.21 (J), U6.25 (K); also elsewhere on the board
/counters/BCD_h0/Clr: U5.23 (Clk); also elsewhere on the board
/counters/BCD_h1/Clr: U5.29 (Clr), U6.29 (Clr), U6.31 (Q); also elsewhere on the board
/counters/BCD_h1/Q0: U5.31 (Q), U6.23 (Clk); also elsewhere on the board

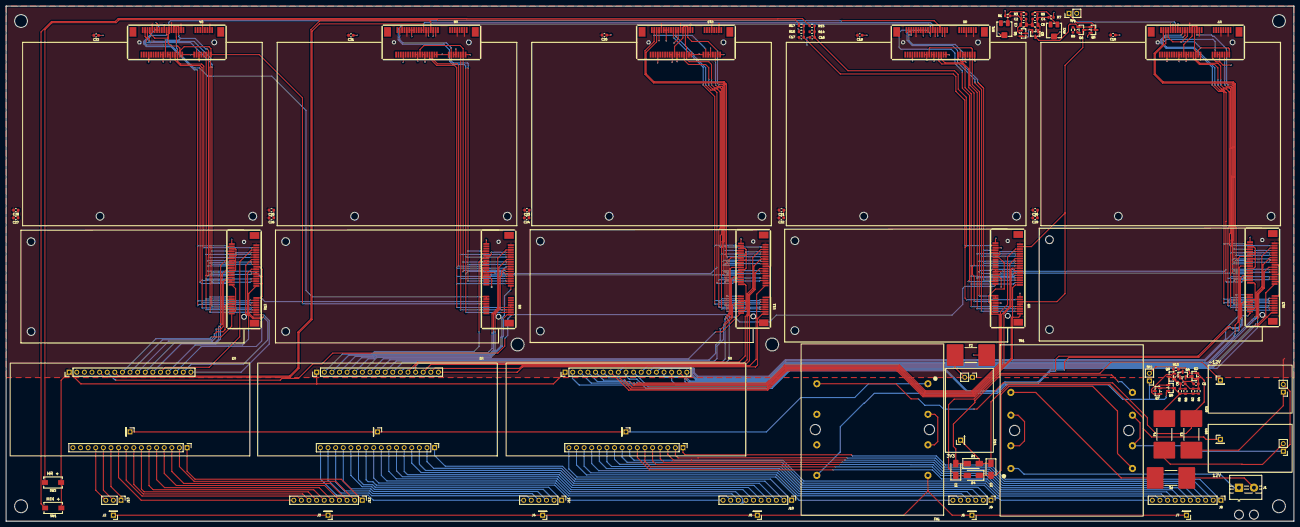
[picture p12: board transistor-clock.kicad_pcb from above]

Board: 2 copper layers, 430.0 x 172.0 mm, 97 parts (0 on the bottom side), 174 nets.
