RoaldVG/transistor-clock/modules/jkflipflop/jkflipflop.kicad_pcb

## KiCad design modules/jkflipflop/jkflipflop.kicad_pcb (2026-04-15)

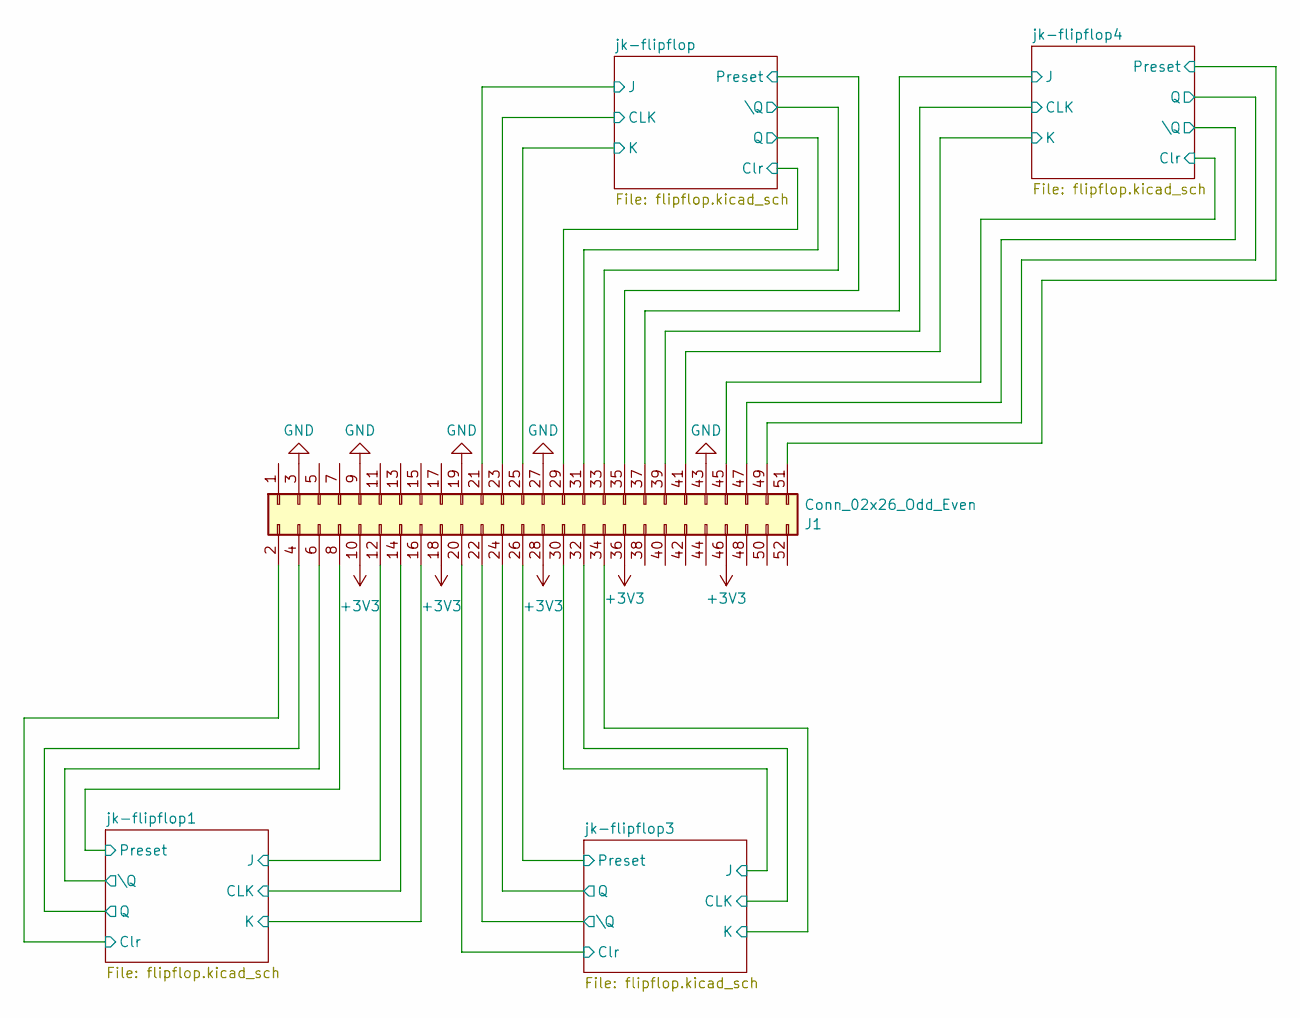
[picture p13: schematic jkflipflop.kicad_sch]

Parts:
J1: Conn_02x26_Odd_Even; mpcie-full-card

Connections:
+3V3: J1.10, J1.18, J1.28, J1.36, J1.46; also elsewhere on the board
/jk-flipflop1/CLK: J1.14; also elsewhere on the board
/jk-flipflop1/Clr: J1.2; also elsewhere on the board
/jk-flipflop1/J: J1.12; also elsewhere on the board
/jk-flipflop1/K: J1.16; also elsewhere on the board
/jk-flipflop1/Preset: J1.8; also elsewhere on the board
/jk-flipflop1/Q: J1.4; also elsewhere on the board
/jk-flipflop1/\Q: J1.6; also elsewhere on the board
/jk-flipflop3/CLK: J1.32; also elsewhere on the board
/jk-flipflop3/Clr: J1.20; also elsewhere on the board
/jk-flipflop3/J: J1.30; also elsewhere on the board
/jk-flipflop3/K: J1.34; also elsewhere on the board
/jk-flipflop3/Preset: J1.26; also elsewhere on the board
/jk-flipflop3/Q: J1.24; also elsewhere on the board
/jk-flipflop3/\Q: J1.22; also elsewhere on the board
/jk-flipflop4/CLK: J1.39; also elsewhere on the board
/jk-flipflop4/Clr: J1.45; also elsewhere on the board
/jk-flipflop4/J: J1.37; also elsewhere on the board
/jk-flipflop4/K: J1.41; also elsewhere on the board
/jk-flipflop4/Preset: J1.51; also elsewhere on the board
/jk-flipflop4/Q: J1.49; also elsewhere on the board
/jk-flipflop4/\Q: J1.47; also elsewhere on the board
/jk-flipflop/CLK: J1.23; also elsewhere on the board
/jk-flipflop/Clr: J1.29; also elsewhere on the board
/jk-flipflop/J: J1.21; also elsewhere on the board
/jk-flipflop/K: J1.25; also elsewhere on the board
/jk-flipflop/Preset: J1.35; also elsewhere on the board
/jk-flipflop/Q: J1.31; also elsewhere on the board
/jk-flipflop/\Q: J1.33; also elsewhere on the board
GND: J1.3, J1.9, J1.19, J1.27, J1.43; also elsewhere on the board

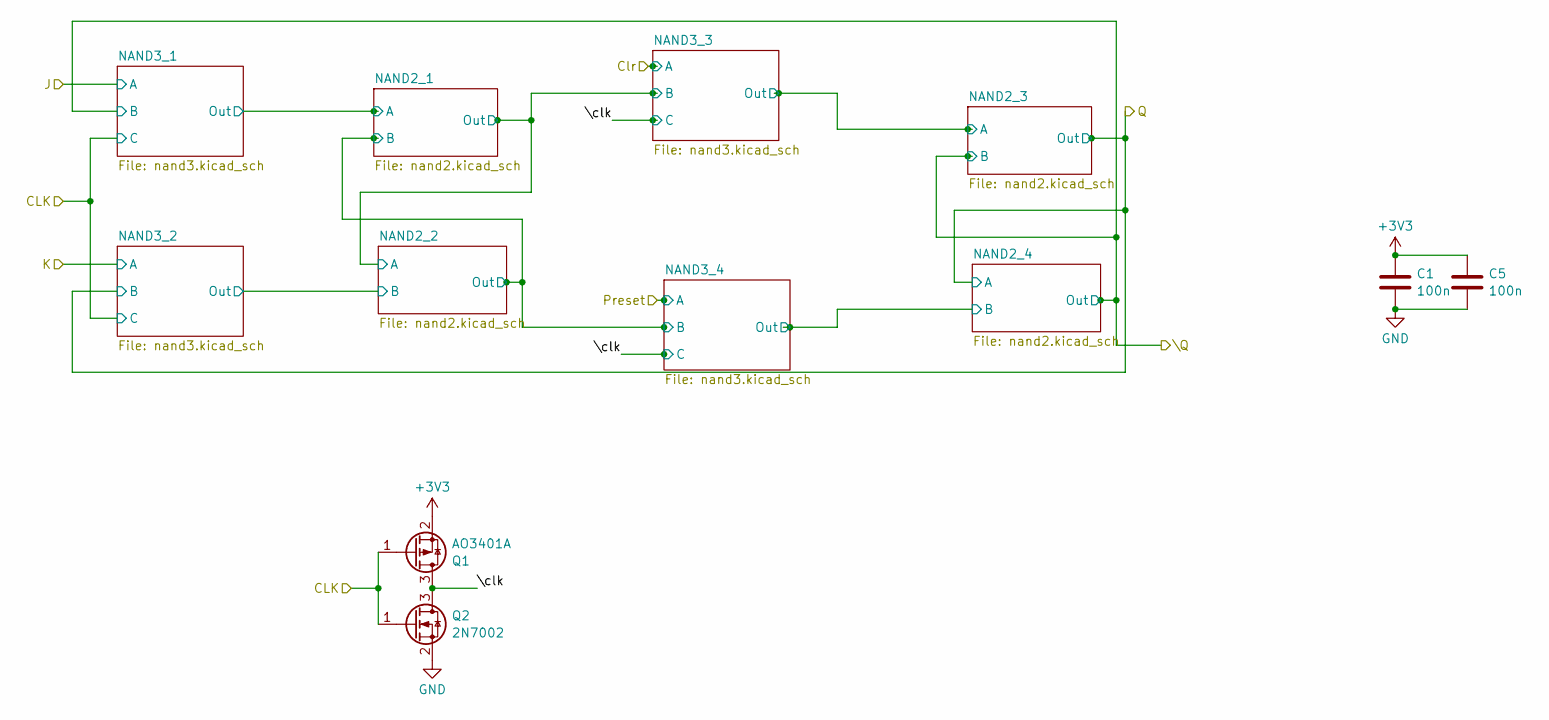
[picture p14: schematic flipflop.kicad_sch]

Parts:
C1, C5: 100n; C_0603_1608Metric; LCSC Part # C14663
Q1: AO3401A; SOT-23; LCSC Part # C15127
Q2: 2N7002; SOT-23; LCSC Part # C8545

Connections:
+3V3: C1.1, C5.1, Q1.2 (S); also elsewhere on the board
/jk-flipflop1/CLK: Q1.1 (G), Q2.1 (G); also elsewhere on the board
/jk-flipflop1/\clk: Q1.3 (D), Q2.3 (D); also elsewhere on the board
GND: C1.2, C5.2, Q2.2 (S); also elsewhere on the board

Parts of its further copies:
C2, C3, C4, C6, C7, C8: 100n; C_0603_1608Metric; LCSC Part # C14663
Q21, Q57, Q77: AO3401A; SOT-23; LCSC Part # C15127
Q22, Q58, Q78: 2N7002; SOT-23; LCSC Part # C8545

Connections of its further copies:
+3V3: C2.1, C3.1, C4.1, C6.1, C7.1, C8.1, Q21.2 (S), Q57.2 (S), Q77.2 (S); also elsewhere on the board
/jk-flipflop3/CLK: Q77.1 (G), Q78.1 (G); also elsewhere on the board
/jk-flipflop3/\clk: Q77.3 (D), Q78.3 (D); also elsewhere on the board
/jk-flipflop4/CLK: Q57.1 (G), Q58.1 (G); also elsewhere on the board
/jk-flipflop4/\clk: Q57.3 (D), Q58.3 (D); also elsewhere on the board
/jk-flipflop/CLK: Q21.1 (G), Q22.1 (G); also elsewhere on the board
/jk-flipflop/\clk: Q21.3 (D), Q22.3 (D); also elsewhere on the board
GND: C2.2, C3.2, C4.2, C6.2, C7.2, C8.2, Q22.2 (S), Q58.2 (S), Q78.2 (S); also elsewhere on the board

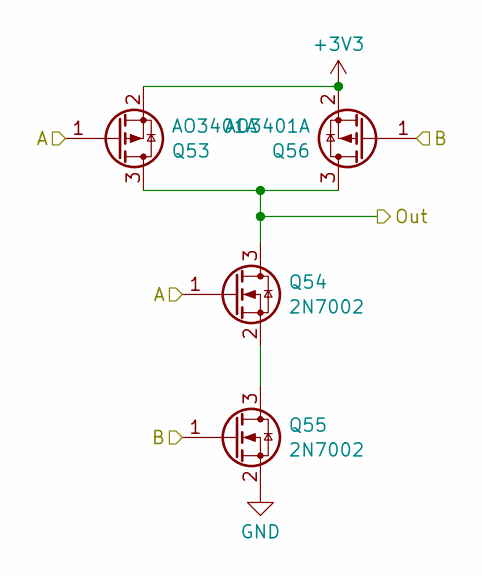
[picture p15: schematic nand2.kicad_sch]

Parts:
Q53, Q56: AO3401A; SOT-23; LCSC Part # C15127
Q54, Q55: 2N7002; SOT-23; LCSC Part # C8545

Connections:
+3V3: Q53.2 (S), Q56.2 (S); also elsewhere on the board
/jk-flipflop1/NAND2_1/B: Q53.3 (D), Q54.3 (D), Q56.3 (D); also elsewhere on the board
/jk-flipflop1/NAND2_1/Out: Q53.1 (G), Q54.1 (G); also elsewhere on the board
/jk-flipflop1/NAND2_2/B: Q55.1 (G), Q56.1 (G); also elsewhere on the board
GND: Q55.2 (S); also elsewhere on the board
unnamed: Q54.2 (S), Q55.3 (D)

Parts of its further copies:
Q104, Q111, Q113, Q116, Q117, Q120, Q121, Q124, Q125, Q128, Q129, Q132, Q133, Q136, Q137, Q140, Q141, Q144, Q145, Q148, Q149, Q152, Q153, Q156, Q157, Q160, Q161, Q164, Q165, Q168: AO3401A; SOT-23; LCSC Part # C15127
Q108, Q109, Q114, Q115, Q118, Q119, Q122, Q123, Q126, Q127, Q130, Q131, Q134, Q135, Q138, Q139, Q142, Q143, Q146, Q147, Q150, Q151, Q154, Q155, Q158, Q159, Q162, Q163, Q166, Q167: 2N7002; SOT-23; LCSC Part # C8545

Connections of its further copies:
+3V3: Q104.2 (S), Q111.2 (S), Q113.2 (S), Q116.2 (S), Q117.2 (S), Q120.2 (S), Q121.2 (S), Q124.2 (S), Q125.2 (S), Q128.2 (S), Q129.2 (S), Q132.2 (S), Q133.2 (S), Q136.2 (S), Q137.2 (S), Q140.2 (S), Q141.2 (S), Q144.2 (S), Q145.2 (S), Q148.2 (S), Q149.2 (S), Q152.2 (S), Q153.2 (S), Q156.2 (S), Q157.2 (S), Q160.2 (S), Q161.2 (S), Q164.2 (S), Q165.2 (S), Q168.2 (S); also elsewhere on the board
/jk-flipflop1/NAND2_1/A: Q157.1 (G), Q158.1 (G); also elsewhere on the board
/jk-flipflop1/NAND2_1/B: Q159.1 (G), Q160.1 (G); also elsewhere on the board
/jk-flipflop1/NAND2_1/Out: Q157.3 (D), Q158.3 (D), Q160.3 (D); also elsewhere on the board
/jk-flipflop1/NAND2_3/A: Q125.1 (G), Q126.1 (G); also elsewhere on the board
/jk-flipflop1/NAND2_4/B: Q131.1 (G), Q132.1 (G); also elsewhere on the board
/jk-flipflop1/Q: Q125.3 (D), Q126.3 (D), Q128.3 (D), Q129.1 (G), Q130.1 (G); also elsewhere on the board
/jk-flipflop1/\Q: Q127.1 (G), Q128.1 (G), Q129.3 (D), Q130.3 (D), Q132.3 (D); also elsewhere on the board
/jk-flipflop3/NAND2_1/A: Q161.1 (G), Q162.1 (G); also elsewhere on the board
/jk-flipflop3/NAND2_1/B: Q121.3 (D), Q122.3 (D), Q124.3 (D), Q163.1 (G), Q164.1 (G); also elsewhere on the board
/jk-flipflop3/NAND2_1/Out: Q121.1 (G), Q122.1 (G), Q161.3 (D), Q162.3 (D), Q164.3 (D); also elsewhere on the board
/jk-flipflop3/NAND2_2/B: Q123.1 (G), Q124.1 (G); also elsewhere on the board
/jk-flipflop3/NAND2_3/A: Q149.1 (G), Q150.1 (G); also elsewhere on the board
/jk-flipflop3/NAND2_4/B: Q155.1 (G), Q156.1 (G); also elsewhere on the board
/jk-flipflop3/Q: Q149.3 (D), Q150.3 (D), Q152.3 (D), Q153.1 (G), Q154.1 (G); also elsewhere on the board
/jk-flipflop3/\Q: Q151.1 (G), Q152.1 (G), Q153.3 (D), Q154.3 (D), Q156.3 (D); also elsewhere on the board
/jk-flipflop4/NAND2_1/A: Q165.1 (G), Q166.1 (G); also elsewhere on the board
/jk-flipflop4/NAND2_1/B: Q117.3 (D), Q118.3 (D), Q120.3 (D), Q167.1 (G), Q168.1 (G); also elsewhere on the board
/jk-flipflop4/NAND2_1/Out: Q117.1 (G), Q118.1 (G), Q165.3 (D), Q166.3 (D), Q168.3 (D); also elsewhere on the board
/jk-flipflop4/NAND2_2/B: Q119.1 (G), Q120.1 (G); also elsewhere on the board
/jk-flipflop4/NAND2_3/A: Q141.1 (G), Q142.1 (G); also elsewhere on the board
/jk-flipflop4/NAND2_4/B: Q147.1 (G), Q148.1 (G); also elsewhere on the board
/jk-flipflop4/Q: Q141.3 (D), Q142.3 (D), Q144.3 (D), Q145.1 (G), Q146.1 (G); also elsewhere on the board
/jk-flipflop4/\Q: Q143.1 (G), Q144.1 (G), Q145.3 (D), Q146.3 (D), Q148.3 (D); also elsewhere on the board
/jk-flipflop/NAND2_1/A: Q104.1 (G), Q108.1 (G); also elsewhere on the board
/jk-flipflop/NAND2_1/B: Q109.1 (G), Q111.1 (G), Q113.3 (D), Q114.3 (D), Q116.3 (D); also elsewhere on the board
/jk-flipflop/NAND2_1/Out: Q104.3 (D), Q108.3 (D), Q111.3 (D), Q113.1 (G), Q114.1 (G); also elsewhere on the board
/jk-flipflop/NAND2_2/B: Q115.1 (G), Q116.1 (G); also elsewhere on the board
/jk-flipflop/NAND2_3/A: Q133.1 (G), Q134.1 (G); also elsewhere on the board
/jk-flipflop/NAND2_4/B: Q139.1 (G), Q140.1 (G); also elsewhere on the board
/jk-flipflop/Q: Q133.3 (D), Q134.3 (D), Q136.3 (D), Q137.1 (G), Q138.1 (G); also elsewhere on the board
/jk-flipflop/\Q: Q135.1 (G), Q136.1 (G), Q137.3 (D), Q138.3 (D), Q140.3 (D); also elsewhere on the board
GND: Q109.2 (S), Q115.2 (S), Q119.2 (S), Q123.2 (S), Q127.2 (S), Q131.2 (S), Q135.2 (S), Q139.2 (S), Q143.2 (S), Q147.2 (S), Q151.2 (S), Q155.2 (S), Q159.2 (S), Q163.2 (S), Q167.2 (S); also elsewhere on the board
unnamed: Q108.2 (S), Q109.3 (D)
unnamed: Q114.2 (S), Q115.3 (D)
unnamed: Q118.2 (S), Q119.3 (D)
unnamed: Q122.2 (S), Q123.3 (D)
unnamed: Q126.2 (S), Q127.3 (D)
unnamed: Q130.2 (S), Q131.3 (D)
unnamed: Q134.2 (S), Q135.3 (D)
unnamed: Q138.2 (S), Q139.3 (D)
unnamed: Q142.2 (S), Q143.3 (D)
unnamed: Q146.2 (S), Q147.3 (D)
unnamed: Q150.2 (S), Q151.3 (D)
unnamed: Q154.2 (S), Q155.3 (D)
unnamed: Q158.2 (S), Q159.3 (D)
unnamed: Q162.2 (S), Q163.3 (D)
unnamed: Q166.2 (S), Q167.3 (D)

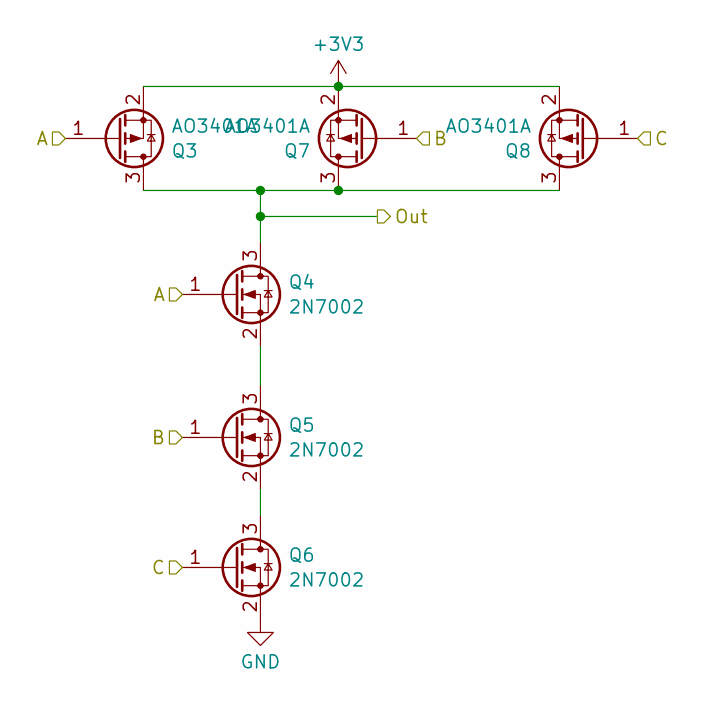
[picture p16: schematic nand3.kicad_sch]

Parts:
Q3, Q7, Q8: AO3401A; SOT-23; LCSC Part # C15127
Q4, Q5, Q6: 2N7002; SOT-23; LCSC Part # C8545

Connections:
+3V3: Q3.2 (S), Q7.2 (S), Q8.2 (S); also elsewhere on the board
/jk-flipflop1/CLK: Q6.1 (G), Q8.1 (G); also elsewhere on the board
/jk-flipflop1/K: Q3.1 (G), Q4.1 (G); also elsewhere on the board
/jk-flipflop1/NAND2_2/B: Q3.3 (D), Q4.3 (D), Q7.3 (D), Q8.3 (D); also elsewhere on the board
/jk-flipflop1/Q: Q5.1 (G), Q7.1 (G); also elsewhere on the board
GND: Q6.2 (S); also elsewhere on the board
unnamed: Q4.2 (S), Q5.3 (D)
unnamed: Q5.2 (S), Q6.3 (D)

Parts of its further copies:
Q9, Q13, Q14, Q15, Q19, Q20, Q23, Q27, Q28, Q29, Q33, Q34, Q35, Q39, Q40, Q41, Q45, Q46, Q47, Q51, Q52, Q59, Q63, Q64, Q65, Q69, Q70, Q71, Q75, Q76, Q79, Q83, Q84, Q85, Q89, Q90, Q91, Q95, Q96, Q97, Q101, Q102, Q103, Q110, Q112: AO3401A; SOT-23; LCSC Part # C15127
Q10, Q11, Q12, Q16, Q17, Q18, Q24, Q25, Q26, Q30, Q31, Q32, Q36, Q37, Q38, Q42, Q43, Q44, Q48, Q49, Q50, Q60, Q61, Q62, Q66, Q67, Q68, Q72, Q73, Q74, Q80, Q81, Q82, Q86, Q87, Q88, Q92, Q93, Q94, Q98, Q99, Q100, Q105, Q106, Q107: 2N7002; SOT-23; LCSC Part # C8545

Connections of its further copies:
+3V3: Q9.2 (S), Q13.2 (S), Q14.2 (S), Q15.2 (S), Q19.2 (S), Q20.2 (S), Q23.2 (S), Q27.2 (S), Q28.2 (S), Q29.2 (S), Q33.2 (S), Q34.2 (S), Q35.2 (S), Q39.2 (S), Q40.2 (S), Q41.2 (S), Q45.2 (S), Q46.2 (S), Q47.2 (S), Q51.2 (S), Q52.2 (S), Q59.2 (S), Q63.2 (S), Q64.2 (S), Q65.2 (S), Q69.2 (S), Q70.2 (S), Q71.2 (S), Q75.2 (S), Q76.2 (S), Q79.2 (S), Q83.2 (S), Q84.2 (S), Q85.2 (S), Q89.2 (S), Q90.2 (S), Q91.2 (S), Q95.2 (S), Q96.2 (S), Q97.2 (S), Q101.2 (S), Q102.2 (S), Q103.2 (S), Q110.2 (S), Q112.2 (S); also elsewhere on the board
/jk-flipflop1/CLK: Q12.1 (G), Q14.1 (G); also elsewhere on the board
/jk-flipflop1/Clr: Q15.1 (G), Q16.1 (G); also elsewhere on the board
/jk-flipflop1/J: Q9.1 (G), Q10.1 (G); also elsewhere on the board
/jk-flipflop1/NAND2_1/A: Q9.3 (D), Q10.3 (D), Q13.3 (D), Q14.3 (D); also elsewhere on the board
/jk-flipflop1/NAND2_1/B: Q49.1 (G), Q51.1 (G); also elsewhere on the board
/jk-flipflop1/NAND2_1/Out: Q17.1 (G), Q19.1 (G); also elsewhere on the board
/jk-flipflop1/NAND2_3/A: Q15.3 (D), Q16.3 (D), Q19.3 (D), Q20.3 (D); also elsewhere on the board
/jk-flipflop1/NAND2_4/B: Q47.3 (D), Q48.3 (D), Q51.3 (D), Q52.3 (D); also elsewhere on the board
/jk-flipflop1/Preset: Q47.1 (G), Q48.1 (G); also elsewhere on the board
/jk-flipflop1/\Q: Q11.1 (G), Q13.1 (G); also elsewhere on the board
/jk-flipflop1/\clk: Q18.1 (G), Q20.1 (G), Q50.1 (G), Q52.1 (G); also elsewhere on the board
/jk-flipflop3/CLK: Q82.1 (G), Q84.1 (G), Q88.1 (G), Q90.1 (G); also elsewhere on the board
/jk-flipflop3/Clr: Q91.1 (G), Q92.1 (G); also elsewhere on the board
/jk-flipflop3/J: Q85.1 (G), Q86.1 (G); also elsewhere on the board
/jk-flipflop3/K: Q79.1 (G), Q80.1 (G); also elsewhere on the board
/jk-flipflop3/NAND2_1/A: Q85.3 (D), Q86.3 (D), Q89.3 (D), Q90.3 (D); also elsewhere on the board
/jk-flipflop3/NAND2_1/B: Q99.1 (G), Q101.1 (G); also elsewhere on the board
/jk-flipflop3/NAND2_1/Out: Q93.1 (G), Q95.1 (G); also elsewhere on the board
/jk-flipflop3/NAND2_2/B: Q79.3 (D), Q80.3 (D), Q83.3 (D), Q84.3 (D); also elsewhere on the board
/jk-flipflop3/NAND2_3/A: Q91.3 (D), Q92.3 (D), Q95.3 (D), Q96.3 (D); also elsewhere on the board
/jk-flipflop3/NAND2_4/B: Q97.3 (D), Q98.3 (D), Q101.3 (D), Q102.3 (D); also elsewhere on the board
/jk-flipflop3/Preset: Q97.1 (G), Q98.1 (G); also elsewhere on the board
/jk-flipflop3/Q: Q81.1 (G), Q83.1 (G); also elsewhere on the board
/jk-flipflop3/\Q: Q87.1 (G), Q89.1 (G); also elsewhere on the board
/jk-flipflop3/\clk: Q94.1 (G), Q96.1 (G), Q100.1 (G), Q102.1 (G); also elsewhere on the board
/jk-flipflop4/CLK: Q74.1 (G), Q76.1 (G), Q107.1 (G), Q112.1 (G); also elsewhere on the board
/jk-flipflop4/Clr: Q59.1 (G), Q60.1 (G); also elsewhere on the board
/jk-flipflop4/J: Q71.1 (G), Q72.1 (G); also elsewhere on the board
/jk-flipflop4/K: Q103.1 (G), Q105.1 (G); also elsewhere on the board
/jk-flipflop4/NAND2_1/A: Q71.3 (D), Q72.3 (D), Q75.3 (D), Q76.3 (D); also elsewhere on the board
/jk-flipflop4/NAND2_1/B: Q67.1 (G), Q69.1 (G); also elsewhere on the board
/jk-flipflop4/NAND2_1/Out: Q61.1 (G), Q63.1 (G); also elsewhere on the board
/jk-flipflop4/NAND2_2/B: Q103.3 (D), Q105.3 (D), Q110.3 (D), Q112.3 (D); also elsewhere on the board
/jk-flipflop4/NAND2_3/A: Q59.3 (D), Q60.3 (D), Q63.3 (D), Q64.3 (D); also elsewhere on the board
/jk-flipflop4/NAND2_4/B: Q65.3 (D), Q66.3 (D), Q69.3 (D), Q70.3 (D); also elsewhere on the board
/jk-flipflop4/Preset: Q65.1 (G), Q66.1 (G); also elsewhere on the board
/jk-flipflop4/Q: Q106.1 (G), Q110.1 (G); also elsewhere on the board
/jk-flipflop4/\Q: Q73.1 (G), Q75.1 (G); also elsewhere on the board
/jk-flipflop4/\clk: Q62.1 (G), Q64.1 (G), Q68.1 (G), Q70.1 (G); also elsewhere on the board
/jk-flipflop/CLK: Q26.1 (G), Q28.1 (G), Q32.1 (G), Q34.1 (G); also elsewhere on the board
/jk-flipflop/Clr: Q35.1 (G), Q36.1 (G); also elsewhere on the board
/jk-flipflop/J: Q23.1 (G), Q24.1 (G); also elsewhere on the board
/jk-flipflop/K: Q29.1 (G), Q30.1 (G); also elsewhere on the board
/jk-flipflop/NAND2_1/A: Q23.3 (D), Q24.3 (D), Q27.3 (D), Q28.3 (D); also elsewhere on the board
/jk-flipflop/NAND2_1/B: Q43.1 (G), Q45.1 (G); also elsewhere on the board
/jk-flipflop/NAND2_1/Out: Q37.1 (G), Q39.1 (G); also elsewhere on the board
/jk-flipflop/NAND2_2/B: Q29.3 (D), Q30.3 (D), Q33.3 (D), Q34.3 (D); also elsewhere on the board
/jk-flipflop/NAND2_3/A: Q35.3 (D), Q36.3 (D), Q39.3 (D), Q40.3 (D); also elsewhere on the board
/jk-flipflop/NAND2_4/B: Q41.3 (D), Q42.3 (D), Q45.3 (D), Q46.3 (D); also elsewhere on the board
/jk-flipflop/Preset: Q41.1 (G), Q42.1 (G); also elsewhere on the board
/jk-flipflop/Q: Q31.1 (G), Q33.1 (G); also elsewhere on the board
/jk-flipflop/\Q: Q25.1 (G), Q27.1 (G); also elsewhere on the board
/jk-flipflop/\clk: Q38.1 (G), Q40.1 (G), Q44.1 (G), Q46.1 (G); also elsewhere on the board
GND: Q12.2 (S), Q18.2 (S), Q26.2 (S), Q32.2 (S), Q38.2 (S), Q44.2 (S), Q50.2 (S), Q62.2 (S), Q68.2 (S), Q74.2 (S), Q82.2 (S), Q88.2 (S), Q94.2 (S), Q100.2 (S), Q107.2 (S); also elsewhere on the board
unnamed: Q10.2 (S), Q11.3 (D)
unnamed: Q11.2 (S), Q12.3 (D)
unnamed: Q16.2 (S), Q17.3 (D)
unnamed: Q17.2 (S), Q18.3 (D)
unnamed: Q24.2 (S), Q25.3 (D)
unnamed: Q25.2 (S), Q26.3 (D)
unnamed: Q30.2 (S), Q31.3 (D)
unnamed: Q31.2 (S), Q32.3 (D)
unnamed: Q36.2 (S), Q37.3 (D)
unnamed: Q37.2 (S), Q38.3 (D)
unnamed: Q42.2 (S), Q43.3 (D)
unnamed: Q43.2 (S), Q44.3 (D)
unnamed: Q48.2 (S), Q49.3 (D)
unnamed: Q49.2 (S), Q50.3 (D)
unnamed: Q60.2 (S), Q61.3 (D)
unnamed: Q61.2 (S), Q62.3 (D)
unnamed: Q66.2 (S), Q67.3 (D)
unnamed: Q67.2 (S), Q68.3 (D)
unnamed: Q72.2 (S), Q73.3 (D)
unnamed: Q73.2 (S), Q74.3 (D)
unnamed: Q80.2 (S), Q81.3 (D)
unnamed: Q81.2 (S), Q82.3 (D)
unnamed: Q86.2 (S), Q87.3 (D)
unnamed: Q87.2 (S), Q88.3 (D)
unnamed: Q92.2 (S), Q93.3 (D)
unnamed: Q93.2 (S), Q94.3 (D)
unnamed: Q98.2 (S), Q99.3 (D)
unnamed: Q99.2 (S), Q100.3 (D)
unnamed: Q105.2 (S), Q106.3 (D)
unnamed: Q106.2 (S), Q107.3 (D)

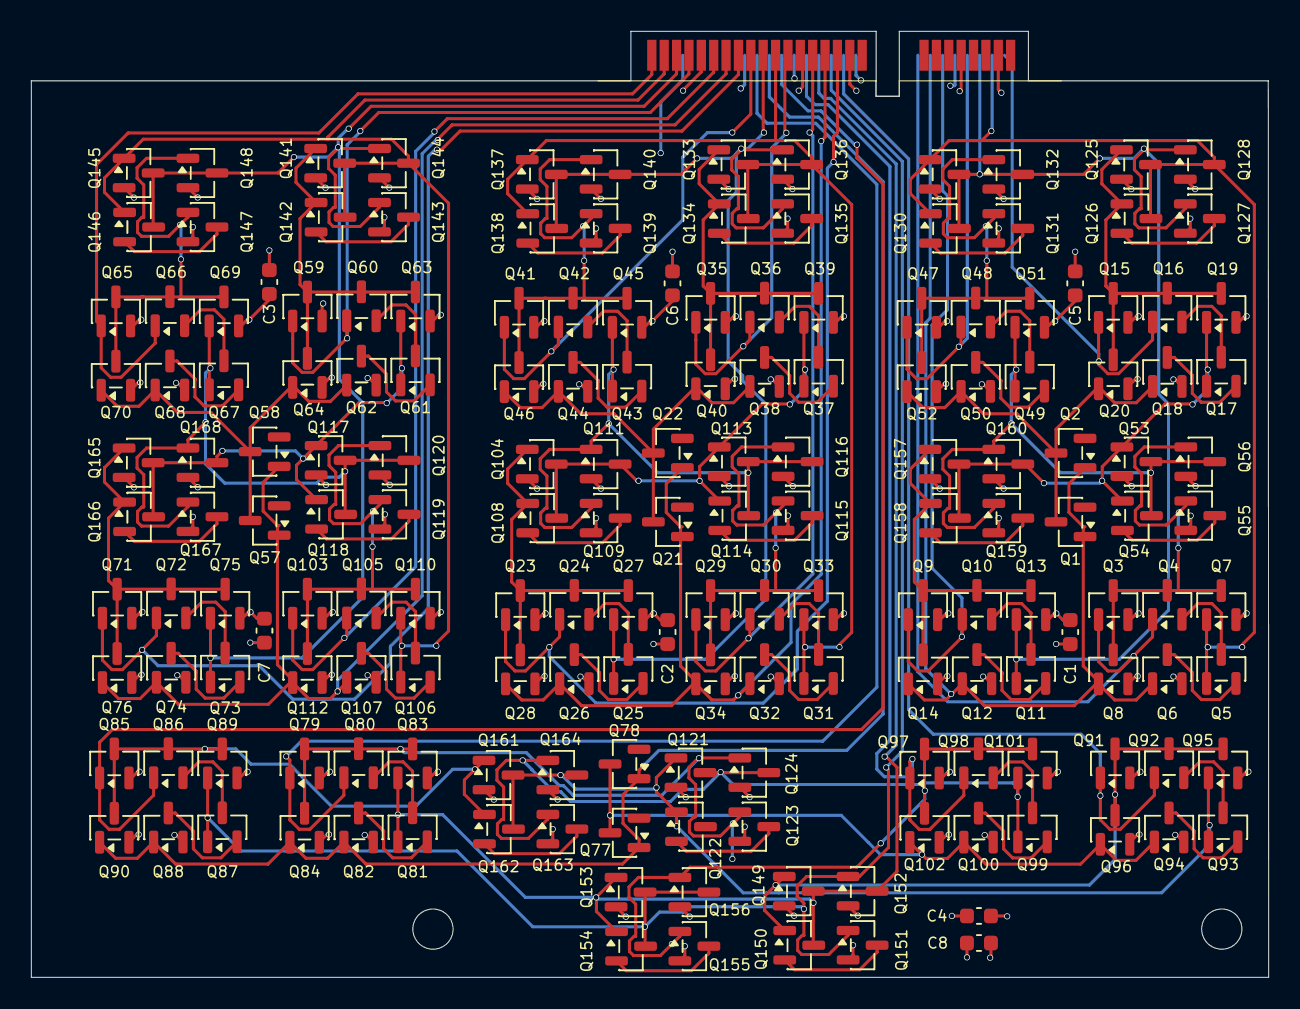
[picture p17: board jkflipflop.kicad_pcb from above]

Board: 4 copper layers, 80.0 x 61.2 mm, 177 parts (0 on the bottom side), 106 nets.
