RoaldVG/transistor-clock/modules/SSR/SSR.kicad_pcb

## KiCad design modules/SSR/SSR.kicad_pcb (2026-04-14)

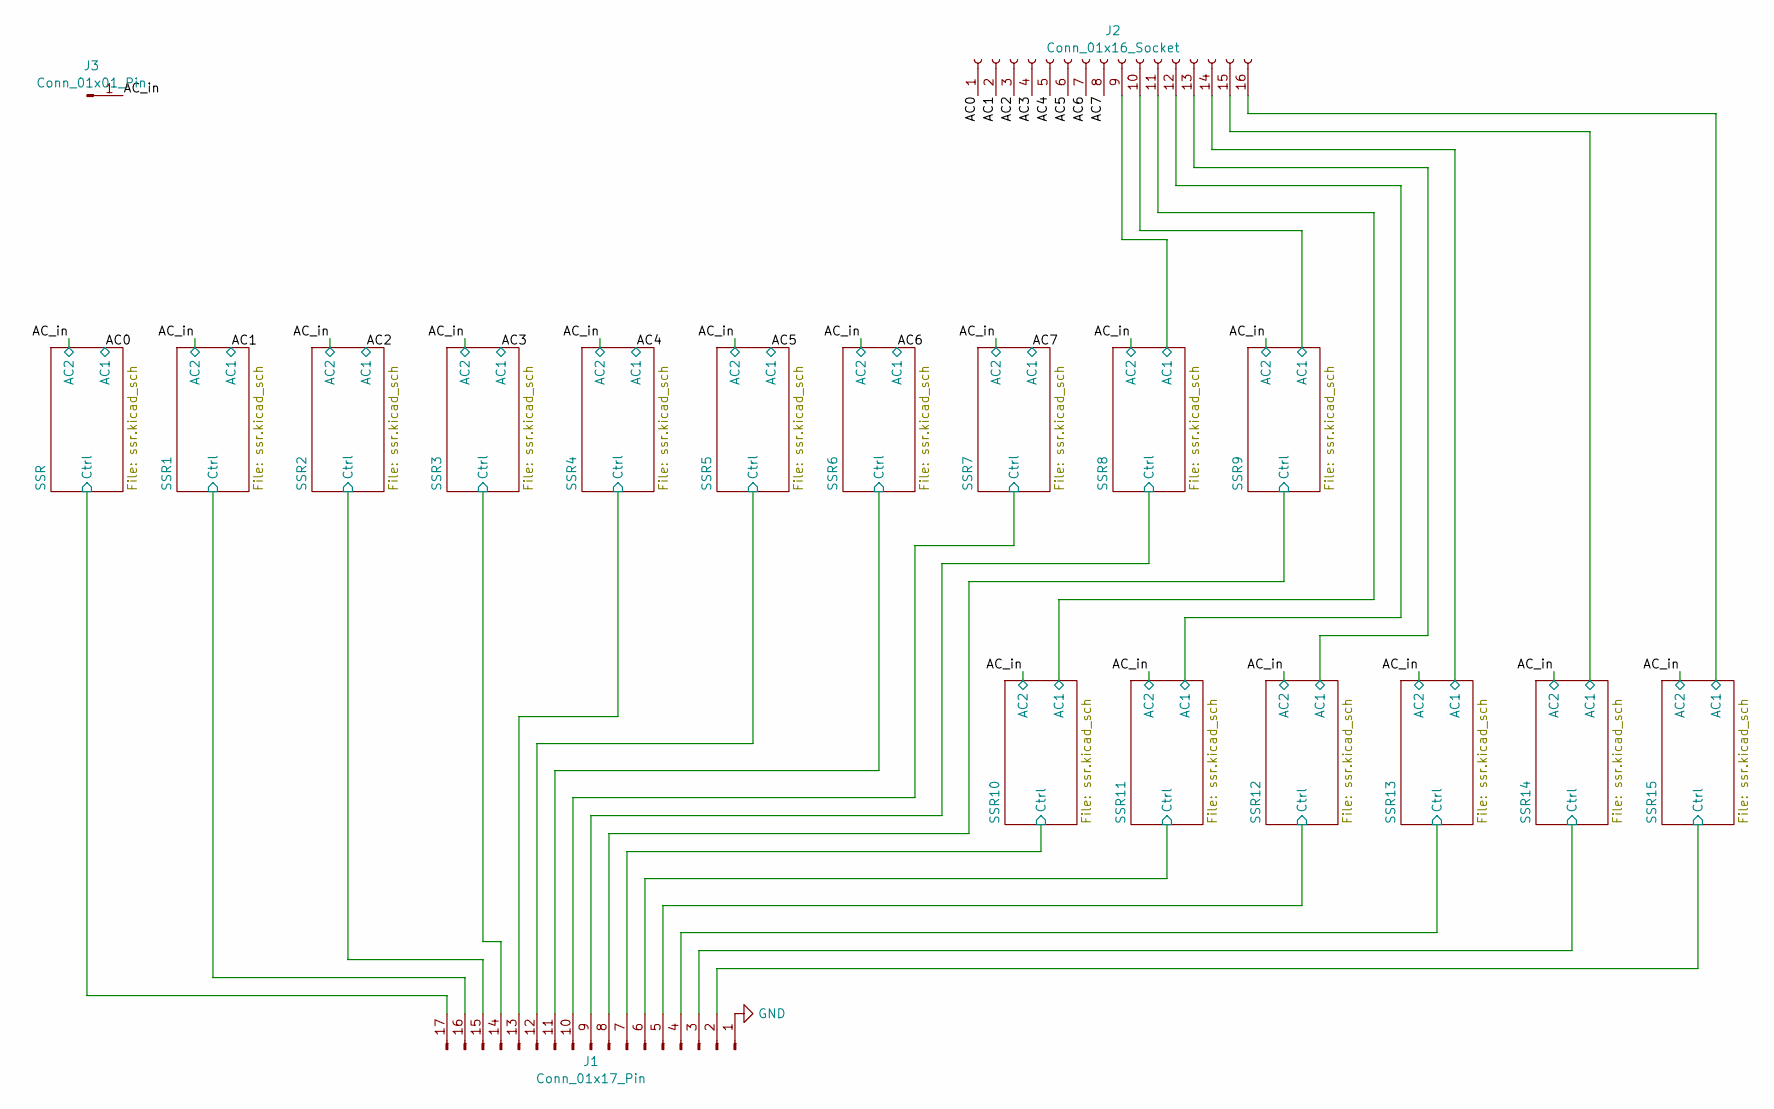
[picture p18: schematic SSR.kicad_sch]

Parts:
J1: Conn_01x17_Pin; PinHeader_1x17_P2.54mm_Vertical
J2: Conn_01x16_Socket; PinHeader_1x16_P2.54mm_Vertical
J3: Conn_01x01_Pin; PinHeader_1x01_P2.54mm_Vertical

Connections:
/AC0: J2.1; also elsewhere on the board
/AC1: J2.2; also elsewhere on the board
/AC2: J2.3; also elsewhere on the board
/AC3: J2.4; also elsewhere on the board
/AC4: J2.5; also elsewhere on the board
/AC5: J2.6; also elsewhere on the board
/AC6: J2.7; also elsewhere on the board
/AC7: J2.8; also elsewhere on the board
/AC_in: J3.1; also elsewhere on the board
/SSR1/Ctrl: J1.16; also elsewhere on the board
/SSR2/Ctrl: J1.15; also elsewhere on the board
/SSR3/Ctrl: J1.14; also elsewhere on the board
/SSR4/Ctrl: J1.13; also elsewhere on the board
/SSR5/Ctrl: J1.12; also elsewhere on the board
/SSR6/Ctrl: J1.11; also elsewhere on the board
/SSR7/Ctrl: J1.10; also elsewhere on the board
/SSR8/AC1: J2.9; also elsewhere on the board
/SSR8/Ctrl: J1.9; also elsewhere on the board
/SSR9/AC1: J2.10; also elsewhere on the board
/SSR9/Ctrl: J1.8; also elsewhere on the board
/SSR10/AC1: J2.11; also elsewhere on the board
/SSR10/Ctrl: J1.7; also elsewhere on the board
/SSR11/AC1: J2.12; also elsewhere on the board
/SSR11/Ctrl: J1.6; also elsewhere on the board
/SSR12/AC1: J2.13; also elsewhere on the board
/SSR12/Ctrl: J1.5; also elsewhere on the board
/SSR13/AC1: J2.14; also elsewhere on the board
/SSR13/Ctrl: J1.4; also elsewhere on the board
/SSR14/AC1: J2.15; also elsewhere on the board
/SSR14/Ctrl: J1.3; also elsewhere on the board
/SSR15/AC1: J2.16; also elsewhere on the board
/SSR15/Ctrl: J1.2; also elsewhere on the board
/SSR/Ctrl: J1.17; also elsewhere on the board
GND: J1.1; also elsewhere on the board

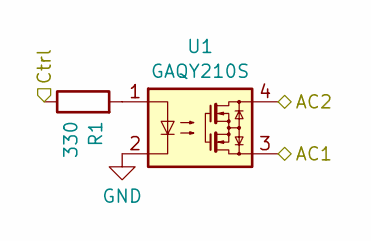
[picture p19: schematic ssr.kicad_sch]

Parts:
R1: 330; R_0603_1608Metric; LCSC Part # C23138
U1: GAQY210S; SOP-4_3.8x4.1mm_P2.54mm; LCSC Part # C7435113

Connections:
/AC0: U1.3; also elsewhere on the board
/AC_in: U1.4; also elsewhere on the board
/SSR/Ctrl: R1.1; also elsewhere on the board
GND: U1.2; also elsewhere on the board
unnamed: R1.2, U1.1

Parts of its further copies:
R2, R3, R4, R5, R6, R7, R8, R9, R10, R11, R12, R13, R14, R15, R16: 330; R_0603_1608Metric; LCSC Part # C23138
U2, U3, U4, U5, U6, U7, U8, U9, U10, U11, U12, U13, U14, U15, U16: GAQY210S; SOP-4_3.8x4.1mm_P2.54mm; LCSC Part # C7435113

Connections of its further copies:
/AC1: U2.3; also elsewhere on the board
/AC2: U3.3; also elsewhere on the board
/AC3: U4.3; also elsewhere on the board
/AC4: U5.3; also elsewhere on the board
/AC5: U6.3; also elsewhere on the board
/AC6: U7.3; also elsewhere on the board
/AC7: U8.3; also elsewhere on the board
/AC_in: U2.4, U3.4, U4.4, U5.4, U6.4, U7.4, U8.4, U9.4, U10.4, U11.4, U12.4, U13.4, U14.4, U15.4, U16.4; also elsewhere on the board
/SSR1/Ctrl: R2.1; also elsewhere on the board
/SSR2/Ctrl: R3.1; also elsewhere on the board
/SSR3/Ctrl: R4.1; also elsewhere on the board
/SSR4/Ctrl: R5.1; also elsewhere on the board
/SSR5/Ctrl: R6.1; also elsewhere on the board
/SSR6/Ctrl: R7.1; also elsewhere on the board
/SSR7/Ctrl: R8.1; also elsewhere on the board
/SSR8/AC1: U9.3; also elsewhere on the board
/SSR8/Ctrl: R9.1; also elsewhere on the board
/SSR9/AC1: U10.3; also elsewhere on the board
/SSR9/Ctrl: R10.1; also elsewhere on the board
/SSR10/AC1: U11.3; also elsewhere on the board
/SSR10/Ctrl: R11.1; also elsewhere on the board
/SSR11/AC1: U12.3; also elsewhere on the board
/SSR11/Ctrl: R12.1; also elsewhere on the board
/SSR12/AC1: U13.3; also elsewhere on the board
/SSR12/Ctrl: R13.1; also elsewhere on the board
/SSR13/AC1: U14.3; also elsewhere on the board
/SSR13/Ctrl: R14.1; also elsewhere on the board
/SSR14/AC1: U15.3; also elsewhere on the board
/SSR14/Ctrl: R15.1; also elsewhere on the board
/SSR15/AC1: U16.3; also elsewhere on the board
/SSR15/Ctrl: R16.1; also elsewhere on the board
GND: U2.2, U3.2, U4.2, U5.2, U6.2, U7.2, U8.2, U9.2, U10.2, U11.2, U12.2, U13.2, U14.2, U15.2, U16.2; also elsewhere on the board
unnamed: R2.2, U2.1
unnamed: R3.2, U3.1
unnamed: R4.2, U4.1
unnamed: R5.2, U5.1
unnamed: R6.2, U6.1
unnamed: R7.2, U7.1
unnamed: R8.2, U8.1
unnamed: R9.2, U9.1
unnamed: R10.2, U10.1
unnamed: R11.2, U11.1
unnamed: R12.2, U12.1
unnamed: R13.2, U13.1
unnamed: R14.2, U14.1
unnamed: R15.2, U15.1
unnamed: R16.2, U16.1

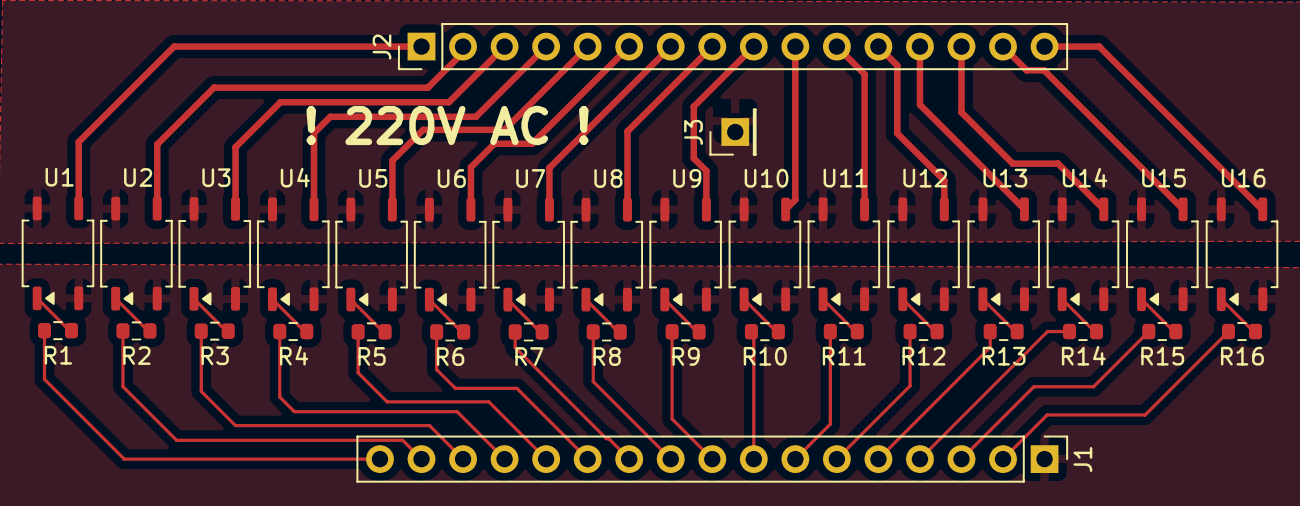
[picture p20: board SSR.kicad_pcb from above]

Board: 2 copper layers, 35 parts (0 on the bottom side), 50 nets.
