RoaldVG/transistor-clock/modules/bin-to-dec/bin-to-dec.kicad_pcb

## KiCad design modules/bin-to-dec/bin-to-dec.kicad_pcb (2026-04-08)

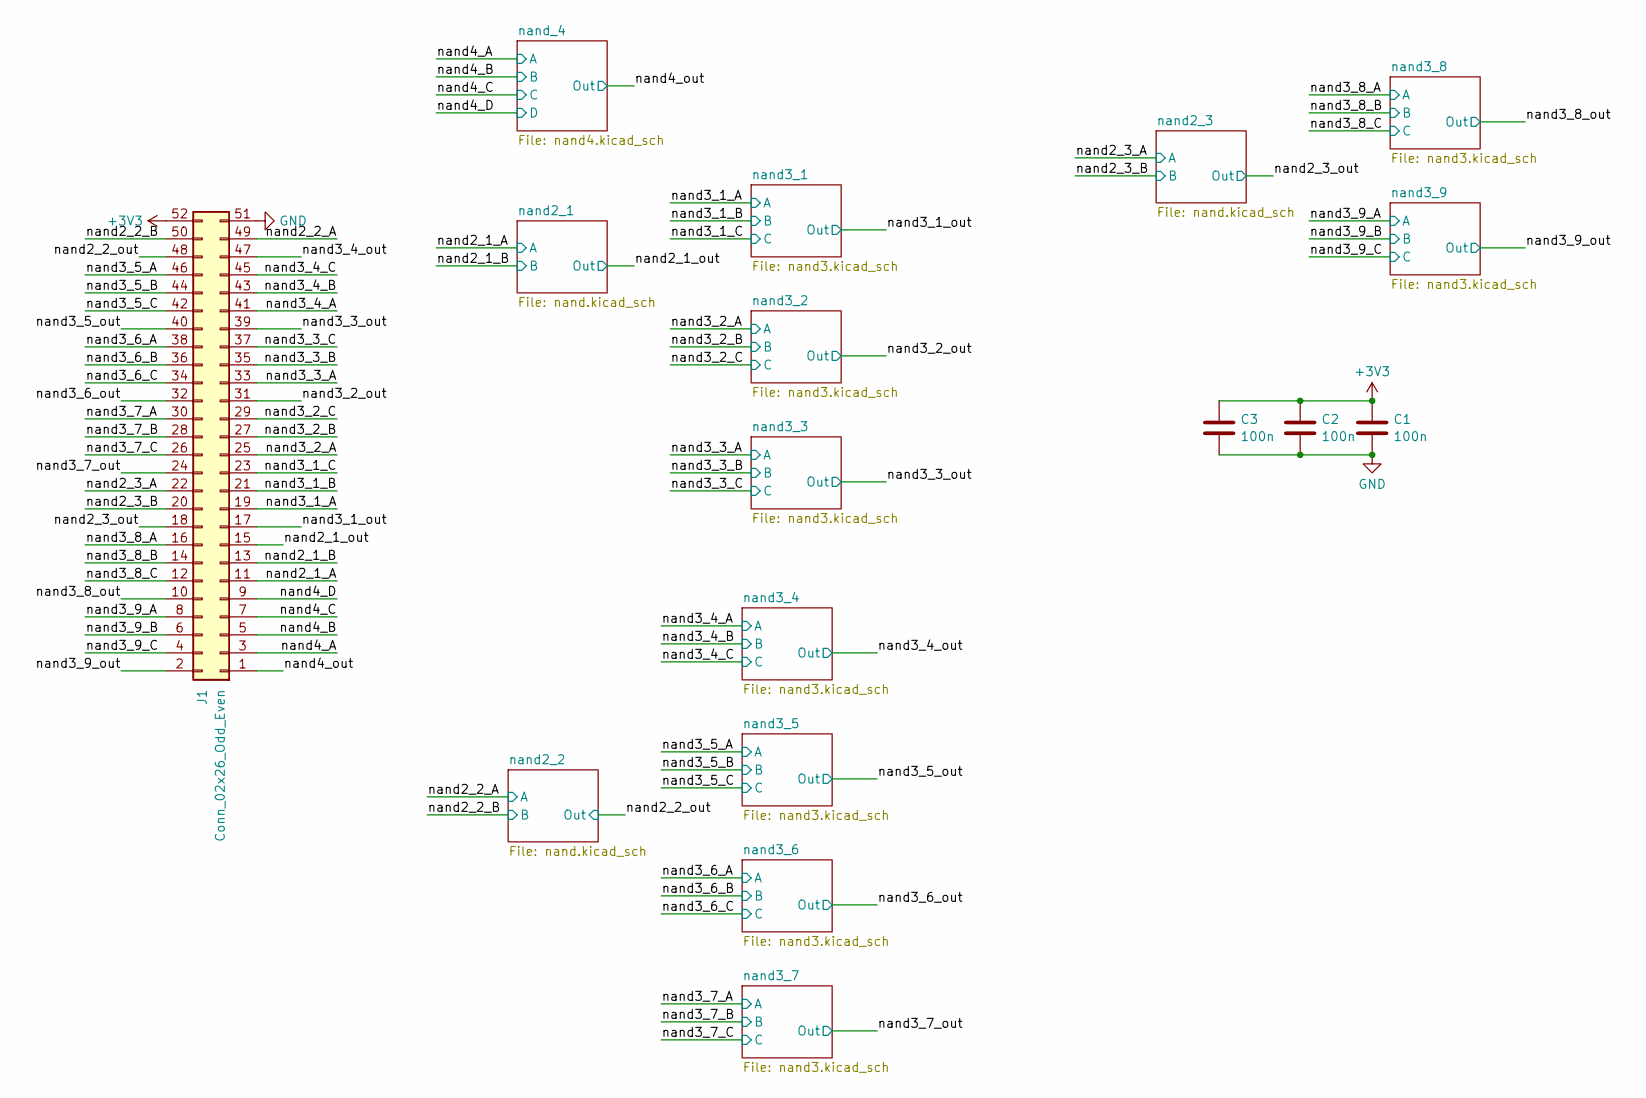
[picture p21: schematic bin-to-dec.kicad_sch]

Parts:
C1, C2, C3: 100n; C_0603_1608Metric; LCSC Part # C14663
J1: Conn_02x26_Odd_Even; mpcie-full-card

Connections:
+3V3: C1.1, C2.1, C3.1, J1.52; also elsewhere on the board
/nand2_1_A: J1.11; also elsewhere on the board
/nand2_1_B: J1.13; also elsewhere on the board
/nand2_1_out: J1.15; also elsewhere on the board
/nand2_2_A: J1.49; also elsewhere on the board
/nand2_2_B: J1.50; also elsewhere on the board
/nand2_2_out: J1.48; also elsewhere on the board
/nand2_3_A: J1.22; also elsewhere on the board
/nand2_3_B: J1.20; also elsewhere on the board
/nand2_3_out: J1.18; also elsewhere on the board
/nand3_1_A: J1.19; also elsewhere on the board
/nand3_1_B: J1.21; also elsewhere on the board
/nand3_1_C: J1.23; also elsewhere on the board
/nand3_1_out: J1.17; also elsewhere on the board
/nand3_2_A: J1.25; also elsewhere on the board
/nand3_2_B: J1.27; also elsewhere on the board
/nand3_2_C: J1.29; also elsewhere on the board
/nand3_2_out: J1.31; also elsewhere on the board
/nand3_3_A: J1.33; also elsewhere on the board
/nand3_3_B: J1.35; also elsewhere on the board
/nand3_3_C: J1.37; also elsewhere on the board
/nand3_3_out: J1.39; also elsewhere on the board
/nand3_4_A: J1.41; also elsewhere on the board
/nand3_4_B: J1.43; also elsewhere on the board
/nand3_4_C: J1.45; also elsewhere on the board
/nand3_4_out: J1.47; also elsewhere on the board
/nand3_5_A: J1.46; also elsewhere on the board
/nand3_5_B: J1.44; also elsewhere on the board
/nand3_5_C: J1.42; also elsewhere on the board
/nand3_5_out: J1.40; also elsewhere on the board
/nand3_6_A: J1.38; also elsewhere on the board
/nand3_6_B: J1.36; also elsewhere on the board
/nand3_6_C: J1.34; also elsewhere on the board
/nand3_6_out: J1.32; also elsewhere on the board
/nand3_7_A: J1.30; also elsewhere on the board
/nand3_7_B: J1.28; also elsewhere on the board
/nand3_7_C: J1.26; also elsewhere on the board
/nand3_7_out: J1.24; also elsewhere on the board
/nand3_8_A: J1.16; also elsewhere on the board
/nand3_8_B: J1.14; also elsewhere on the board
/nand3_8_C: J1.12; also elsewhere on the board
/nand3_8_out: J1.10; also elsewhere on the board
/nand3_9_A: J1.8; also elsewhere on the board
/nand3_9_B: J1.6; also elsewhere on the board
/nand3_9_C: J1.4; also elsewhere on the board
/nand3_9_out: J1.2; also elsewhere on the board
/nand4_A: J1.3; also elsewhere on the board
/nand4_B: J1.5; also elsewhere on the board
/nand4_C: J1.7; also elsewhere on the board
/nand4_D: J1.9; also elsewhere on the board
/nand4_out: J1.1; also elsewhere on the board
GND: C1.2, C2.2, C3.2, J1.51; also elsewhere on the board

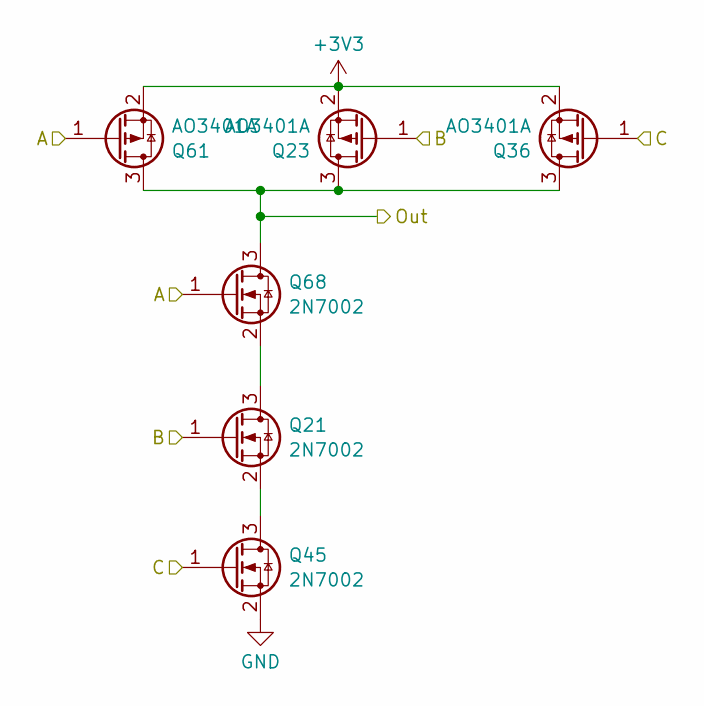
[picture p22: schematic nand3.kicad_sch]

Parts:
Q21, Q45, Q68: 2N7002; SOT-23; LCSC Part # C8545
Q23, Q36, Q61: AO3401A; SOT-23; LCSC Part # C15127

Connections:
+3V3: Q23.2 (S), Q36.2 (S), Q61.2 (S); also elsewhere on the board
/nand3_1_A: Q61.1 (G), Q68.1 (G); also elsewhere on the board
/nand3_1_B: Q21.1 (G), Q23.1 (G); also elsewhere on the board
/nand3_1_C: Q36.1 (G), Q45.1 (G); also elsewhere on the board
/nand3_1_out: Q23.3 (D), Q36.3 (D), Q61.3 (D), Q68.3 (D); also elsewhere on the board
GND: Q45.2 (S); also elsewhere on the board
unnamed: Q21.3 (D), Q68.2 (S)
unnamed: Q21.2 (S), Q45.3 (D)

Parts of its further copies:
Q1, Q4, Q9, Q10, Q11, Q14, Q20, Q28, Q29, Q30, Q31, Q32, Q38, Q39, Q40, Q42, Q43, Q48, Q49, Q60, Q63, Q69, Q71, Q73: 2N7002; SOT-23; LCSC Part # C8545
Q2, Q3, Q5, Q13, Q15, Q17, Q22, Q24, Q33, Q34, Q35, Q37, Q41, Q44, Q47, Q52, Q62, Q64, Q65, Q66, Q67, Q70, Q72, Q74: AO3401A; SOT-23; LCSC Part # C15127

Connections of its further copies:
+3V3: Q2.2 (S), Q3.2 (S), Q5.2 (S), Q13.2 (S), Q15.2 (S), Q17.2 (S), Q22.2 (S), Q24.2 (S), Q33.2 (S), Q34.2 (S), Q35.2 (S), Q37.2 (S), Q41.2 (S), Q44.2 (S), Q47.2 (S), Q52.2 (S), Q62.2 (S), Q64.2 (S), Q65.2 (S), Q66.2 (S), Q67.2 (S), Q70.2 (S), Q72.2 (S), Q74.2 (S); also elsewhere on the board
/nand3_2_A: Q35.1 (G), Q43.1 (G); also elsewhere on the board
/nand3_2_B: Q38.1 (G), Q41.1 (G); also elsewhere on the board
/nand3_2_C: Q37.1 (G), Q40.1 (G); also elsewhere on the board
/nand3_2_out: Q35.3 (D), Q37.3 (D), Q41.3 (D), Q43.3 (D); also elsewhere on the board
/nand3_3_A: Q4.1 (G), Q13.1 (G); also elsewhere on the board
/nand3_3_B: Q14.1 (G), Q17.1 (G); also elsewhere on the board
/nand3_3_C: Q9.1 (G), Q15.1 (G); also elsewhere on the board
/nand3_3_out: Q4.3 (D), Q13.3 (D), Q15.3 (D), Q17.3 (D); also elsewhere on the board
/nand3_4_A: Q3.1 (G), Q11.1 (G); also elsewhere on the board
/nand3_4_B: Q5.1 (G), Q10.1 (G); also elsewhere on the board
/nand3_4_C: Q1.1 (G), Q2.1 (G); also elsewhere on the board
/nand3_4_out: Q2.3 (D), Q3.3 (D), Q5.3 (D), Q11.3 (D); also elsewhere on the board
/nand3_5_A: Q39.1 (G), Q44.1 (G); also elsewhere on the board
/nand3_5_B: Q34.1 (G), Q42.1 (G); also elsewhere on the board
/nand3_5_C: Q48.1 (G), Q52.1 (G); also elsewhere on the board
/nand3_5_out: Q34.3 (D), Q39.3 (D), Q44.3 (D), Q52.3 (D); also elsewhere on the board
/nand3_6_A: Q29.1 (G), Q33.1 (G); also elsewhere on the board
/nand3_6_B: Q22.1 (G), Q28.1 (G); also elsewhere on the board
/nand3_6_C: Q20.1 (G), Q24.1 (G); also elsewhere on the board
/nand3_6_out: Q22.3 (D), Q24.3 (D), Q29.3 (D), Q33.3 (D); also elsewhere on the board
/nand3_7_A: Q32.1 (G), Q70.1 (G); also elsewhere on the board
/nand3_7_B: Q31.1 (G), Q64.1 (G); also elsewhere on the board
/nand3_7_C: Q30.1 (G), Q62.1 (G); also elsewhere on the board
/nand3_7_out: Q32.3 (D), Q62.3 (D), Q64.3 (D), Q70.3 (D); also elsewhere on the board
/nand3_8_A: Q47.1 (G), Q49.1 (G); also elsewhere on the board
/nand3_8_B: Q73.1 (G), Q74.1 (G); also elsewhere on the board
/nand3_8_C: Q71.1 (G), Q72.1 (G); also elsewhere on the board
/nand3_8_out: Q47.3 (D), Q49.3 (D), Q72.3 (D), Q74.3 (D); also elsewhere on the board
/nand3_9_A: Q63.1 (G), Q67.1 (G); also elsewhere on the board
/nand3_9_B: Q65.1 (G), Q69.1 (G); also elsewhere on the board
/nand3_9_C: Q60.1 (G), Q66.1 (G); also elsewhere on the board
/nand3_9_out: Q63.3 (D), Q65.3 (D), Q66.3 (D), Q67.3 (D); also elsewhere on the board
GND: Q1.2 (S), Q9.2 (S), Q20.2 (S), Q30.2 (S), Q40.2 (S), Q48.2 (S), Q60.2 (S), Q71.2 (S); also elsewhere on the board
unnamed: Q1.3 (D), Q10.2 (S)
unnamed: Q10.3 (D), Q11.2 (S)
unnamed: Q4.2 (S), Q14.3 (D)
unnamed: Q9.3 (D), Q14.2 (S)
unnamed: Q20.3 (D), Q28.2 (S)
unnamed: Q28.3 (D), Q29.2 (S)
unnamed: Q30.3 (D), Q31.2 (S)
unnamed: Q31.3 (D), Q32.2 (S)
unnamed: Q38.3 (D), Q43.2 (S)
unnamed: Q38.2 (S), Q40.3 (D)
unnamed: Q39.2 (S), Q42.3 (D)
unnamed: Q42.2 (S), Q48.3 (D)
unnamed: Q49.2 (S), Q73.3 (D)
unnamed: Q60.3 (D), Q69.2 (S)
unnamed: Q63.2 (S), Q69.3 (D)
unnamed: Q71.3 (D), Q73.2 (S)

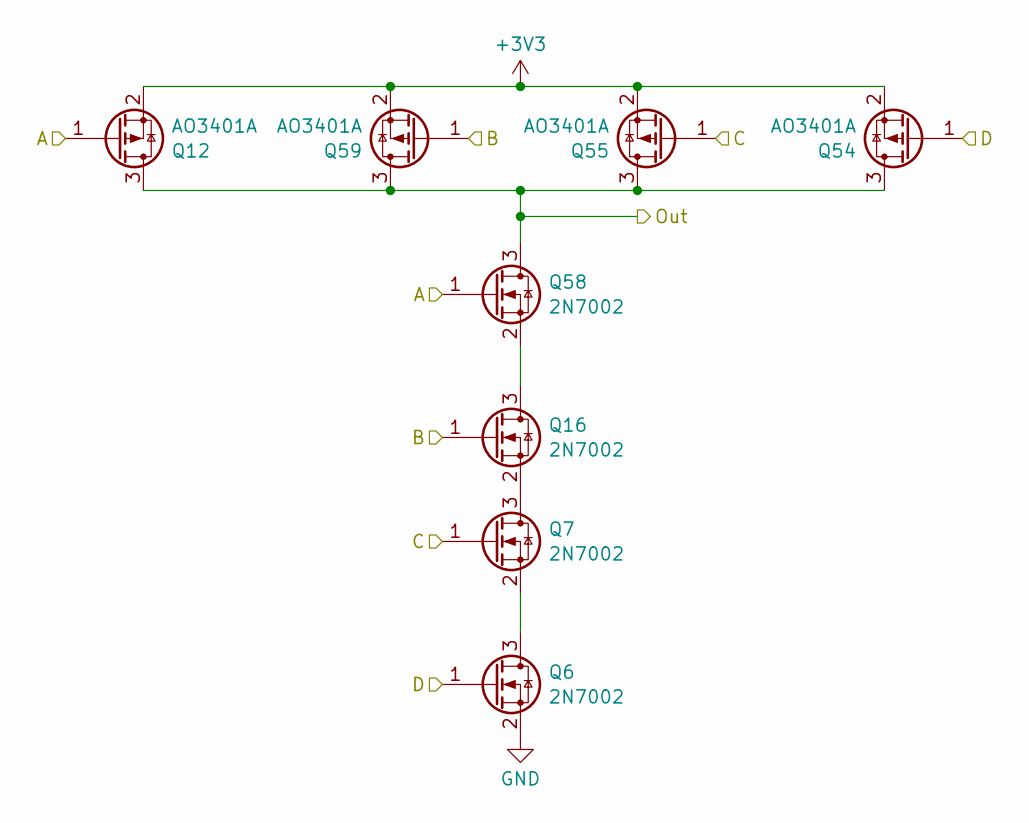
[picture p23: schematic nand4.kicad_sch]

Parts:
Q6, Q7, Q16, Q58: 2N7002; SOT-23; LCSC Part # C8545
Q12, Q54, Q55, Q59: AO3401A; SOT-23; LCSC Part # C15127

Connections:
+3V3: Q12.2 (S), Q54.2 (S), Q55.2 (S), Q59.2 (S); also elsewhere on the board
/nand4_A: Q12.1 (G), Q58.1 (G); also elsewhere on the board
/nand4_B: Q16.1 (G), Q59.1 (G); also elsewhere on the board
/nand4_C: Q7.1 (G), Q55.1 (G); also elsewhere on the board
/nand4_D: Q6.1 (G), Q54.1 (G); also elsewhere on the board
/nand4_out: Q12.3 (D), Q54.3 (D), Q55.3 (D), Q58.3 (D), Q59.3 (D); also elsewhere on the board
GND: Q6.2 (S); also elsewhere on the board
unnamed: Q6.3 (D), Q7.2 (S)
unnamed: Q16.3 (D), Q58.2 (S)
unnamed: Q7.3 (D), Q16.2 (S)

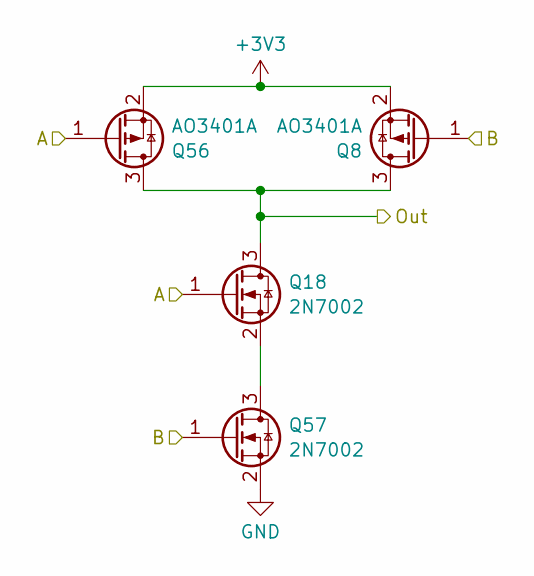
[picture p24: schematic nand.kicad_sch]

Parts:
Q8, Q56: AO3401A; SOT-23; LCSC Part # C15127
Q18, Q57: 2N7002; SOT-23; LCSC Part # C8545

Connections:
+3V3: Q8.2 (S), Q56.2 (S); also elsewhere on the board
/nand2_1_A: Q18.1 (G), Q56.1 (G); also elsewhere on the board
/nand2_1_B: Q8.1 (G), Q57.1 (G); also elsewhere on the board
/nand2_1_out: Q8.3 (D), Q18.3 (D), Q56.3 (D); also elsewhere on the board
GND: Q57.2 (S); also elsewhere on the board
unnamed: Q18.2 (S), Q57.3 (D)

Parts of its further copies:
Q19, Q25, Q46, Q51: 2N7002; SOT-23; LCSC Part # C8545
Q26, Q27, Q50, Q53: AO3401A; SOT-23; LCSC Part # C15127

Connections of its further copies:
+3V3: Q26.2 (S), Q27.2 (S), Q50.2 (S), Q53.2 (S); also elsewhere on the board
/nand2_2_A: Q25.1 (G), Q26.1 (G); also elsewhere on the board
/nand2_2_B: Q19.1 (G), Q27.1 (G); also elsewhere on the board
/nand2_2_out: Q25.3 (D), Q26.3 (D), Q27.3 (D); also elsewhere on the board
/nand2_3_A: Q51.1 (G), Q53.1 (G); also elsewhere on the board
/nand2_3_B: Q46.1 (G), Q50.1 (G); also elsewhere on the board
/nand2_3_out: Q50.3 (D), Q51.3 (D), Q53.3 (D); also elsewhere on the board
GND: Q19.2 (S), Q46.2 (S); also elsewhere on the board
unnamed: Q19.3 (D), Q25.2 (S)
unnamed: Q46.3 (D), Q51.2 (S)

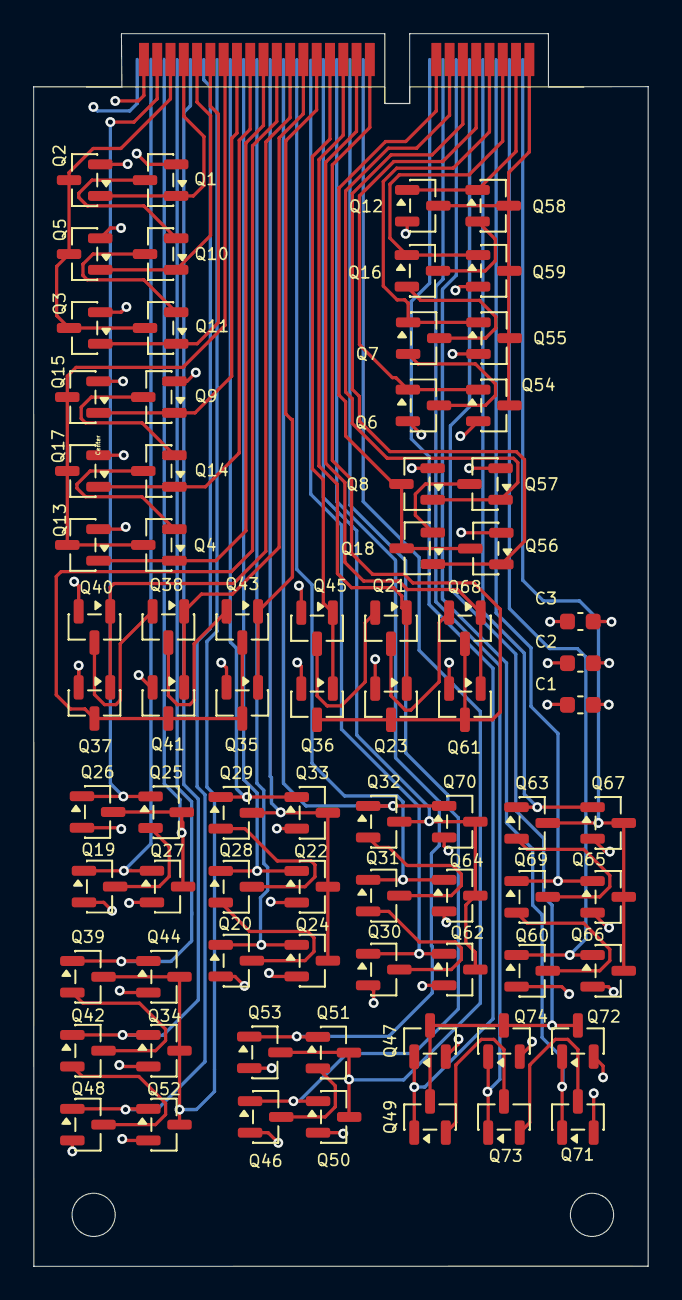
[picture p25: board modules/bin-to-dec/bin-to-dec.kicad_pcb from above]

Board: 4 copper layers, 37.0 x 74.2 mm, 78 parts (0 on the bottom side), 76 nets.
