RoaldVG/transistor-clock/modules/bin-to-dec/bin-to-dec/bin-to-dec.kicad_pcb

## KiCad design modules/bin-to-dec/bin-to-dec/bin-to-dec.kicad_pcb (2026-03-25, an earlier design)

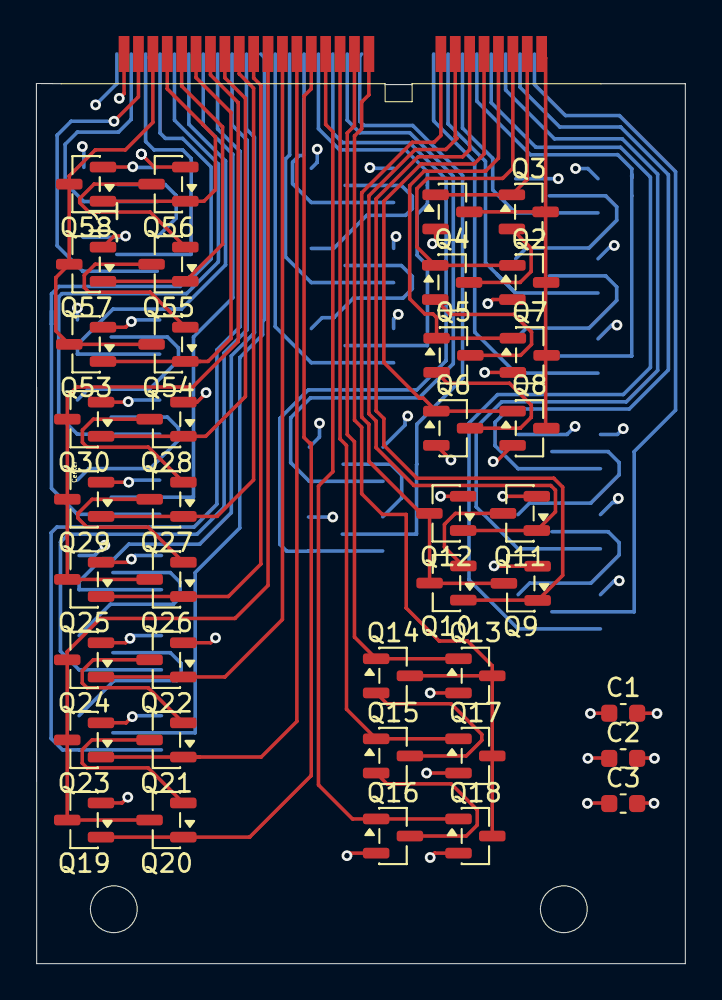
[picture p26: board modules/bin-to-dec/bin-to-dec/bin-to-dec.kicad_pcb from above]

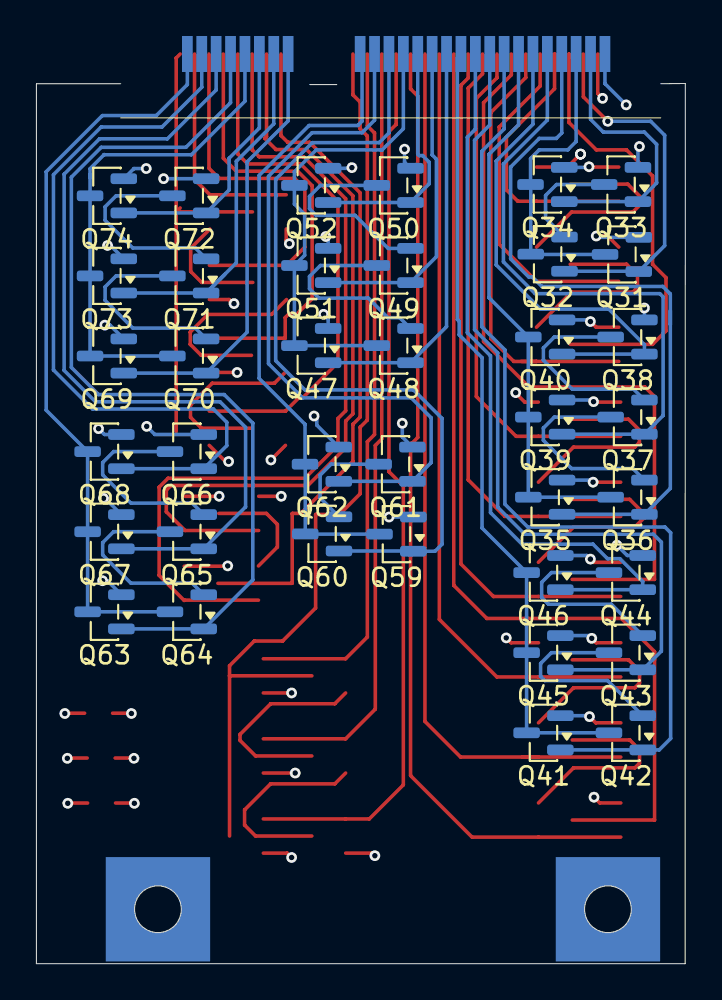
[picture p27: board modules/bin-to-dec/bin-to-dec/bin-to-dec.kicad_pcb from below]

Board: 4 copper layers, 36.1 x 48.9 mm, 78 parts (38 on the bottom side), 76 nets.

Parts:
C1, C2, C3: 100n; C_0603_1608Metric
J1: Conn_02x26_Odd_Even; mpcie-full-card
Q1, Q2, Q7, Q8, Q9, Q12, Q13, Q17, Q18, Q19, Q23, Q24, Q25, Q29, Q30, Q31, Q34, Q35, Q39, Q40, Q41, Q45, Q46, Q47, Q51, Q52, Q53, Q57, Q58, Q59, Q62, Q63, Q67, Q68, Q69, Q73, Q74: DMP3099L; SOT-23
Q3, Q4, Q5, Q6, Q10, Q11, Q14, Q15, Q16, Q20, Q21, Q22, Q26, Q27, Q28, Q32, Q33, Q36, Q37, Q38, Q42, Q43, Q44, Q48, Q49, Q50, Q54, Q55, Q56, Q60, Q61, Q64, Q65, Q66, Q70, Q71, Q72: 2N7002; SOT-23

Connections:
+3V3: C1.1, C2.1, C3.1, J1.52, Q1.2 (S), Q2.2 (S), Q7.2 (S), Q8.2 (S), Q9.2 (S), Q12.2 (S), Q13.2 (S), Q17.2 (S), Q18.2 (S), Q19.2 (S), Q23.2 (S), Q24.2 (S), Q25.2 (S), Q29.2 (S), Q30.2 (S), Q31.2 (S), Q34.2 (S), Q35.2 (S), Q39.2 (S), Q40.2 (S), Q41.2 (S), Q45.2 (S), Q46.2 (S), Q47.2 (S), Q51.2 (S), Q52.2 (S), Q53.2 (S), Q57.2 (S), Q58.2 (S), Q59.2 (S), Q62.2 (S), Q63.2 (S), Q67.2 (S), Q68.2 (S), Q69.2 (S), Q73.2 (S), Q74.2 (S)
/nand2_1_A: J1.11, Q9.1 (G), Q10.1 (G)
/nand2_1_B: J1.13, Q11.1 (G), Q12.1 (G)
/nand2_1_out: J1.15, Q9.3 (D), Q10.3 (D), Q12.3 (D)
/nand2_2_A: J1.49, Q31.1 (G), Q32.1 (G)
/nand2_2_B: J1.50, Q33.1 (G), Q34.1 (G)
/nand2_2_out: J1.48, Q31.3 (D), Q32.3 (D), Q34.3 (D)
/nand2_3_A: J1.22, Q59.1 (G), Q60.1 (G)
/nand2_3_B: J1.20, Q61.1 (G), Q62.1 (G)
/nand2_3_out: J1.18, Q59.3 (D), Q60.3 (D), Q62.3 (D)
/nand3_1_A: J1.19, Q13.1 (G), Q14.1 (G)
/nand3_1_B: J1.21, Q15.1 (G), Q17.1 (G)
/nand3_1_C: J1.23, Q16.1 (G), Q18.1 (G)
/nand3_1_out: J1.17, Q13.3 (D), Q14.3 (D), Q17.3 (D), Q18.3 (D)
/nand3_2_A: J1.25, Q19.1 (G), Q20.1 (G)
/nand3_2_B: J1.27, Q21.1 (G), Q23.1 (G)
/nand3_2_C: J1.29, Q22.1 (G), Q24.1 (G)
/nand3_2_out: J1.31, Q19.3 (D), Q20.3 (D), Q23.3 (D), Q24.3 (D)
/nand3_3_A: J1.33, Q25.1 (G), Q26.1 (G)
/nand3_3_B: J1.35, Q27.1 (G), Q29.1 (G)
/nand3_3_C: J1.37, Q28.1 (G), Q30.1 (G)
/nand3_3_out: J1.39, Q25.3 (D), Q26.3 (D), Q29.3 (D), Q30.3 (D)
/nand3_4_A: J1.41, Q53.1 (G), Q54.1 (G)
/nand3_4_B: J1.43, Q55.1 (G), Q57.1 (G)
/nand3_4_C: J1.45, Q56.1 (G), Q58.1 (G)
/nand3_4_out: J1.47, Q53.3 (D), Q54.3 (D), Q57.3 (D), Q58.3 (D)
/nand3_5_A: J1.46, Q35.1 (G), Q36.1 (G)
/nand3_5_B: J1.44, Q37.1 (G), Q39.1 (G)
/nand3_5_C: J1.42, Q38.1 (G), Q40.1 (G)
/nand3_5_out: J1.40, Q35.3 (D), Q36.3 (D), Q39.3 (D), Q40.3 (D)
/nand3_6_A: J1.38, Q41.1 (G), Q42.1 (G)
/nand3_6_B: J1.36, Q43.1 (G), Q45.1 (G)
/nand3_6_C: J1.34, Q44.1 (G), Q46.1 (G)
/nand3_6_out: J1.32, Q41.3 (D), Q42.3 (D), Q45.3 (D), Q46.3 (D)
/nand3_7_A: J1.30, Q47.1 (G), Q48.1 (G)
/nand3_7_B: J1.28, Q49.1 (G), Q51.1 (G)
/nand3_7_C: J1.26, Q50.1 (G), Q52.1 (G)
/nand3_7_out: J1.24, Q47.3 (D), Q48.3 (D), Q51.3 (D), Q52.3 (D)
/nand3_8_A: J1.16, Q69.1 (G), Q70.1 (G)
/nand3_8_B: J1.14, Q71.1 (G), Q73.1 (G)
/nand3_8_C: J1.12, Q72.1 (G), Q74.1 (G)
/nand3_8_out: J1.10, Q69.3 (D), Q70.3 (D), Q73.3 (D), Q74.3 (D)
/nand3_9_A: J1.8, Q63.1 (G), Q64.1 (G)
/nand3_9_B: J1.6, Q65.1 (G), Q67.1 (G)
/nand3_9_C: J1.4, Q66.1 (G), Q68.1 (G)
/nand3_9_out: J1.2, Q63.3 (D), Q64.3 (D), Q67.3 (D), Q68.3 (D)
/nand4_A: J1.3, Q1.1 (G), Q3.1 (G)
/nand4_B: J1.5, Q2.1 (G), Q4.1 (G)
/nand4_C: J1.7, Q5.1 (G), Q7.1 (G)
/nand4_D: J1.9, Q6.1 (G), Q8.1 (G)
/nand4_out: J1.1, Q1.3 (D), Q2.3 (D), Q3.3 (D), Q7.3 (D), Q8.3 (D)
GND: C1.2, C2.2, C3.2, J1.51, Q6.2 (S), Q11.2 (S), Q16.2 (S), Q22.2 (S), Q28.2 (S), Q33.2 (S), Q38.2 (S), Q44.2 (S), Q50.2 (S), Q56.2 (S), Q61.2 (S), Q66.2 (S), Q72.2 (S)
unnamed: Q3.2 (S), Q4.3 (D)
unnamed: Q4.2 (S), Q5.3 (D)
unnamed: Q5.2 (S), Q6.3 (D)
unnamed: Q10.2 (S), Q11.3 (D)
unnamed: Q14.2 (S), Q15.3 (D)
unnamed: Q15.2 (S), Q16.3 (D)
unnamed: Q20.2 (S), Q21.3 (D)
unnamed: Q21.2 (S), Q22.3 (D)
unnamed: Q26.2 (S), Q27.3 (D)
unnamed: Q27.2 (S), Q28.3 (D)
unnamed: Q32.2 (S), Q33.3 (D)
unnamed: Q36.2 (S), Q37.3 (D)
unnamed: Q37.2 (S), Q38.3 (D)
unnamed: Q42.2 (S), Q43.3 (D)
unnamed: Q43.2 (S), Q44.3 (D)
unnamed: Q48.2 (S), Q49.3 (D)
unnamed: Q49.2 (S), Q50.3 (D)
unnamed: Q54.2 (S), Q55.3 (D)
unnamed: Q55.2 (S), Q56.3 (D)
unnamed: Q60.2 (S), Q61.3 (D)
unnamed: Q64.2 (S), Q65.3 (D)
unnamed: Q65.2 (S), Q66.3 (D)
unnamed: Q70.2 (S), Q71.3 (D)
unnamed: Q71.2 (S), Q72.3 (D)
