RoaldVG/transistor-clock/(commit log)

2026-02-28 init commit
    [and.kicad_sch, and4.kicad_sch, and5.kicad_sch, bcd.kicad_sch, bcd2.kicad_sch, bcd6.kicad_sch, bdc.kicad_sch, bdc6.kicad_sch]
2026-03-04 moved to 3v3
    [counters.kicad_sch, nor.kicad_sch, relays10.kicad_sch, relays6.kicad_sch, transistor-clock.kicad_sch]
2026-03-04 added decoupling caps
    [and.kicad_sch, bcd.kicad_sch, bcd2.kicad_sch, bcd6.kicad_sch, counters.kicad_sch, jkflipflop.kicad_sch, nand.kicad_sch, nand3.kicad_sch]
2026-03-04 changed rectifier diodes
    [transistor-clock.kicad_sch]
2026-03-05 corrected output/input type of pins
    [and.kicad_sch, bcd.kicad_sch, bcd2.kicad_sch, bcd6.kicad_sch, bdc.kicad_sch, bdc6.kicad_sch, counters.kicad_sch, jkflipflop.kicad_sch]
2026-03-19 schematic cleanup, routed 1 bdc
    [and.kicad_sch, bcd.kicad_sch, bcd2.kicad_sch, bcd6.kicad_sch, bdc.kicad_sch, counters.kicad_sch, jkflipflop.kicad_sch, nand.kicad_sch]
2026-03-19 started modular approach
    [flipflop.kicad_sch, jkflipkflop.kicad_pcb, jkflipkflop.kicad_sch, nand3.kicad_sch]
2026-03-20 changed from pcie x1 to mini pcie. added 2 flipflops
    [flipflop.kicad_sch, jkflipkflop.kicad_pcb, jkflipkflop.kicad_sch, nand3.kicad_sch]
2026-03-20 started on binary to decimal converter
    [bcd.kicad_sch, bcd2.kicad_sch, bcd6.kicad_sch, bdc.kicad_sch, bin-to-dec.kicad_pcb, bin-to-dec.kicad_sch, counters.kicad_sch, jkflipflop.kicad_sch]
2026-03-21 routed on bdc
    [bdc.kicad_sch, bin-to-dec.kicad_pcb, bin-to-dec.kicad_sch, nand.kicad_sch, nand3.kicad_sch, nand4.kicad_sch]
2026-03-25 went from routed bin-to-dec to gate only
    [bin-to-dec.kicad_pcb, bin-to-dec.kicad_sch, nand.kicad_sch, nand3.kicad_sch, nand4.kicad_sch]
2026-03-27 move to correct dir. improved symmetry of pcb
    [bdc.kicad_sch, bin-to-dec.kicad_pcb, bin-to-dec.kicad_sch, nand.kicad_sch, nand3.kicad_sch, nand4.kicad_sch]
2026-03-27 DRC. added fab outputs
    [bin-to-dec-B_Cu.gbr, bin-to-dec-B_Mask.gbr, bin-to-dec-B_Paste.gbr, bin-to-dec-B_Silkscreen.gbr, bin-to-dec-Edge_Cuts.gbr, bin-to-dec-F_Cu.gbr, bin-to-dec-F_Mask.gbr, bin-to-dec-F_Paste.gbr]
2026-03-30 using plugin to generate jlc production files
    [bin-to-dec-B_Cu.gbr, bin-to-dec-B_Mask.gbr, bin-to-dec-B_Paste.gbr, bin-to-dec-B_Silkscreen.gbr, bin-to-dec-Edge_Cuts.gbr, bin-to-dec-F_Cu.gbr, bin-to-dec-F_Mask.gbr, bin-to-dec-F_Paste.gbr]
2026-03-30 move components to top layer :(
    [bin-to-dec.kicad_pcb, bin-to-dec.kicad_sch, bom.csv, nand.kicad_sch, nand3.kicad_sch, nand4.kicad_sch, positions.csv]
2026-03-30 switched to jlc basic components
    [bin-to-dec.kicad_pcb, bin-to-dec.kicad_sch, bom.csv, nand.kicad_sch, nand3.kicad_sch, nand4.kicad_sch]
2026-03-30 moved designators
    [bin-to-dec.kicad_pcb]
2026-03-31 replace bcd logic with bin-to-dec module
    [bcd.kicad_sch, bcd2.kicad_sch, bcd6.kicad_sch, bdc.kicad_sch, bdc6.kicad_sch, counters.kicad_sch, jkflipflop.kicad_sch, nand.kicad_sch]
2026-03-31 flipflop fab output
    [bom.csv, designators.csv, flipflop.kicad_sch, jkflipkflop.kicad_pcb, jkflipkflop.kicad_sch, nand3.kicad_sch, positions.csv]
2026-03-31 fixed typo
    [bom.csv, designators.csv, flipflop.kicad_sch, jkflipkflop.kicad_pcb, jkflipkflop.kicad_sch, nand3.kicad_sch, positions.csv]
2026-03-31 minor edits
    [bin-to-dec.kicad_sch, nand.kicad_sch, nand3.kicad_sch, nand4.kicad_sch]
2026-03-31 actually corrected typo
    [jkflipflop.kicad_pcb, jkflipflop.kicad_sch]
2026-04-01 switched to using flipflop module
    [bcd.kicad_sch, bcd2.kicad_sch, bcd6.kicad_sch, bdc.kicad_sch, counters.kicad_sch, jkflipflop.kicad_sch, nand.kicad_sch, nand3.kicad_sch]
2026-04-01 schematic cleanup
    [counters.kicad_sch, transistor-clock.kicad_sch]
2026-04-01 module for SSRs
    [SSR.kicad_pcb, SSR.kicad_sch, ssr.kicad_sch]
2026-04-01 production output for SSR module
    [SSR.kicad_pcb, SSR.kicad_sch, bom.csv, designators.csv, positions.csv, ssr.kicad_sch]
2026-04-01 switched to using SSR module
    [bcd.kicad_sch, bcd2.kicad_sch, bcd6.kicad_sch, bdc.kicad_sch, counters.kicad_sch, relays10.kicad_sch, relays6.kicad_sch, ssr.kicad_sch]
2026-04-01 added LCSC part numbers
    [bcd.kicad_sch, bcd2.kicad_sch, bcd6.kicad_sch, bdc.kicad_sch, bdc6.kicad_sch, counters.kicad_sch, relays10.kicad_sch, relays6.kicad_sch]
2026-04-07 switched clock to bjt astable multivibrator
    [bdc6.kicad_sch, counters.kicad_sch, relays10.kicad_sch, relays6.kicad_sch, transistor-clock.kicad_sch]
2026-04-08 changed some components to lcsc parts
    [bcd.kicad_sch, bdc.kicad_sch, bdc6.kicad_sch, counters.kicad_sch, transistor-clock.kicad_sch]
2026-04-08 added footprints for modules
    [SSR.kicad_pcb, bcd.kicad_sch, bcd2.kicad_sch, bcd6.kicad_sch, bdc.kicad_sch, bdc6.kicad_sch, bin-to-dec.kicad_pcb, counters.kicad_sch]
2026-04-08 added module for PSU
    [PSU.kicad_pcb, PSU.kicad_sch, bcd.kicad_sch, bcd2.kicad_sch, bcd6.kicad_sch, bdc.kicad_sch, bdc6.kicad_sch, counters.kicad_sch]
2026-04-11 some routing on main board
    [counters.kicad_sch, transistor-clock.kicad_pcb, transistor-clock.kicad_sch]
2026-04-13 routy mcRouteface
    [bdc.kicad_sch, bdc6.kicad_sch, bom.csv, counters.kicad_sch, designators.csv, positions.csv, transistor-clock.kicad_pcb]
2026-04-14 flipflop wip
    [counters.kicad_sch, flipflop.kicad_sch, jkflipflop.kicad_pcb, jkflipflop.kicad_sch, nand2.kicad_sch, nand3.kicad_sch, transistor-clock.kicad_pcb, transistor-clock.kicad_sch]
2026-04-15 flipflop routing wip
    [flipflop.kicad_sch, jkflipflop.kicad_pcb]
2026-04-15 routed flipflops
    [jkflipflop.kicad_pcb, jkflipflop.kicad_sch]
2026-04-15 updated production files
    [bom.csv, designators.csv, jkflipflop.kicad_pcb, positions.csv, transistor-clock.kicad_pcb]
2026-04-15 PSU production files
    [bom.csv, designators.csv, positions.csv]
2026-04-15 forgot to caps on flipflop module
    [jkflipflop.kicad_pcb, positions.csv]
2026-04-15 cleanup and DRC
    [transistor-clock.kicad_pcb, transistor-clock.kicad_sch]
2026-04-15 PSU: added power led
    [PSU.kicad_pcb, PSU.kicad_sch, bom.csv, designators.csv, positions.csv]
2026-04-24 flipflop sims
    [bcd.kicad_sch, bcd6.kicad_sch]
2026-04-24 change clock to 2hz? does input flipflop half it?
    [transistor-clock.kicad_sch]
